617quan/NeonCarrot/CAD Files/PCB_Lid_a.stl

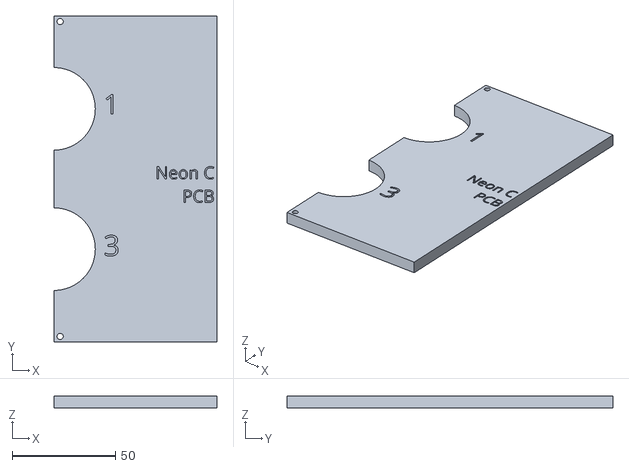
[picture p1: CAD file, 2026-05-02]
CAD Files/PCB_Lid_a.stl
79.0 x 158.0 x 6.00
