617quan/NeonCarrot/KiCad/12_Driver_Board/DRV8434PWPR/PWP0028M.stp

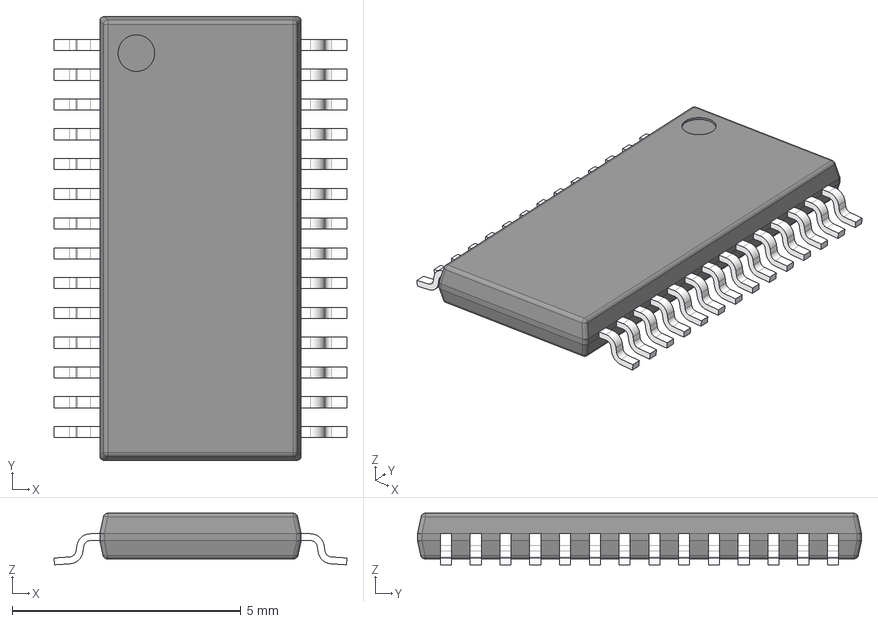
[picture p2: CAD file, 2026-02-03]
KiCad/12_Driver_Board/DRV8434PWPR/PWP0028M.stp
6.40 x 9.70 x 1.13 mm
BODY-TSSOP
LEAD-TSSOP x 28
PIN1
DAP
