617quan/NeonCarrot/KiCad/12_Driver_Board/ESP32-DEVKIT-V1/ESP32-DEVKIT-V1.step

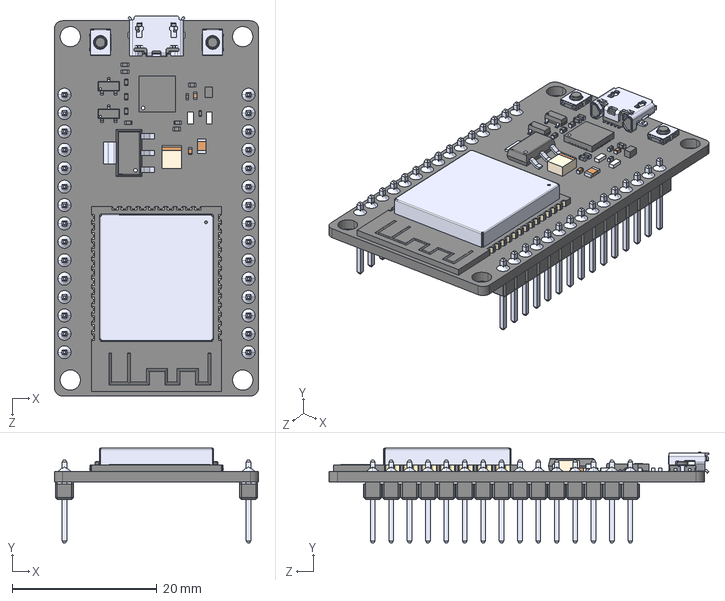
[picture p3: CAD file, 2026-02-25]
KiCad/12_Driver_Board/ESP32-DEVKIT-V1/ESP32-DEVKIT-V1.step
28.2 x 13.1 x 52.5 mm
