617quan/NeonCarrot/KiCad/12_Driver_Board/GRM188R71H224KAC4D/GRM188R71H224KAC4D.step

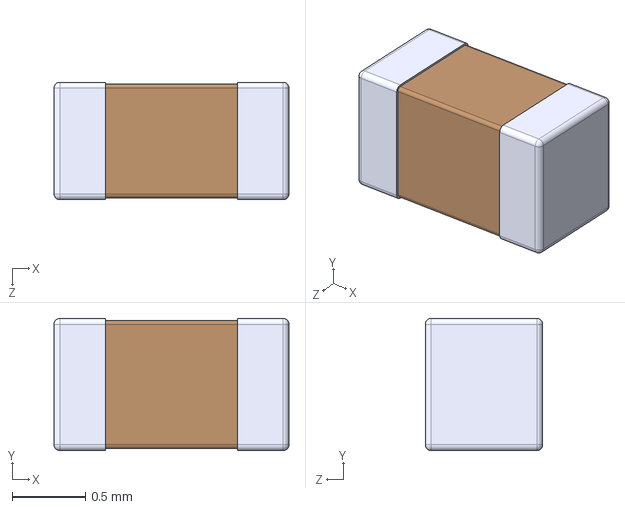
[picture p4: CAD file, 2026-02-05]
KiCad/12_Driver_Board/GRM188R71H224KAC4D/GRM188R71H224KAC4D.step
1.60 x 0.9 x 0.8 mm
