617quan/NeonCarrot/KiCad/12_Driver_Board/UMK107AB7105KA_T/UMK107AB7105KA-T.step

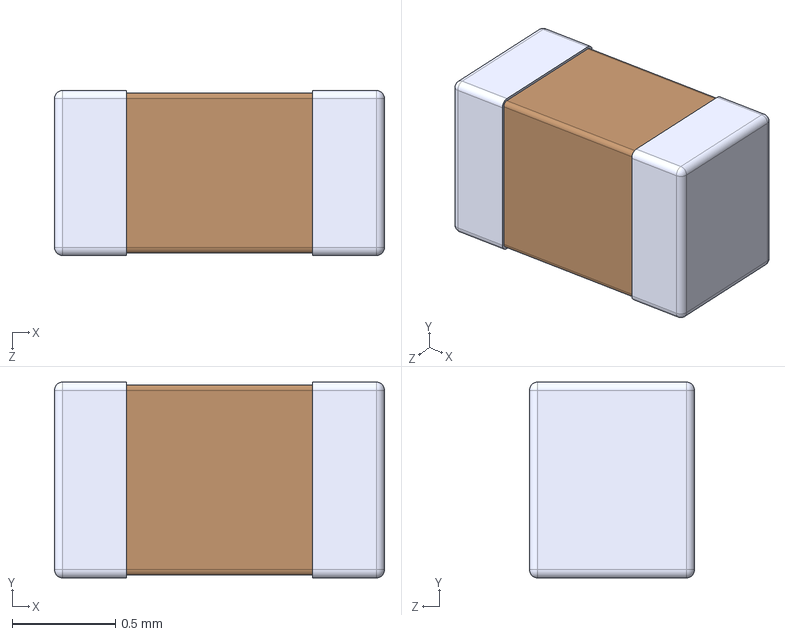
[picture p5: CAD file, 2026-02-05]
KiCad/12_Driver_Board/UMK107AB7105KA_T/UMK107AB7105KA-T.step
1.60 x 0.95 x 0.8 mm
