617quan/NeonCarrot/KiCad/2ESP_Breakout/JST-PH_Connectors/B6B-PH-K-S.step

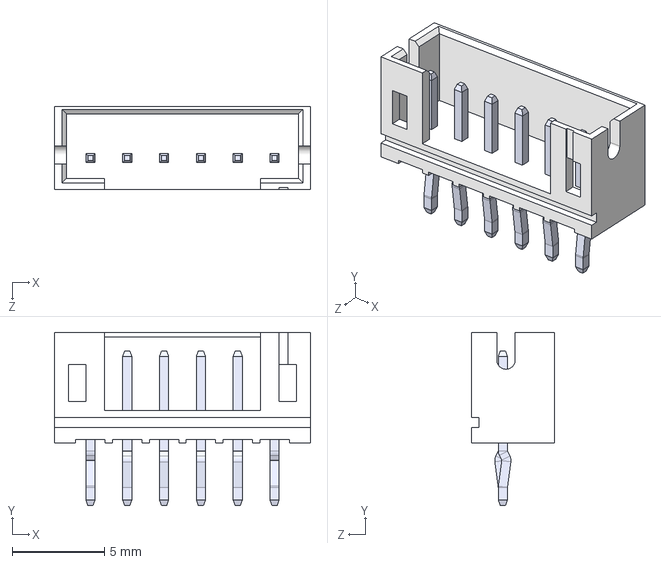
[picture p6: CAD file, 2026-01-23]
KiCad/2ESP_Breakout/JST-PH_Connectors/B6B-PH-K-S.step
13.9 x 9.40 x 4.50 mm
pin x 6
