617quan/NeonCarrot/CAD Files/PCB_Case_Bottom.stl

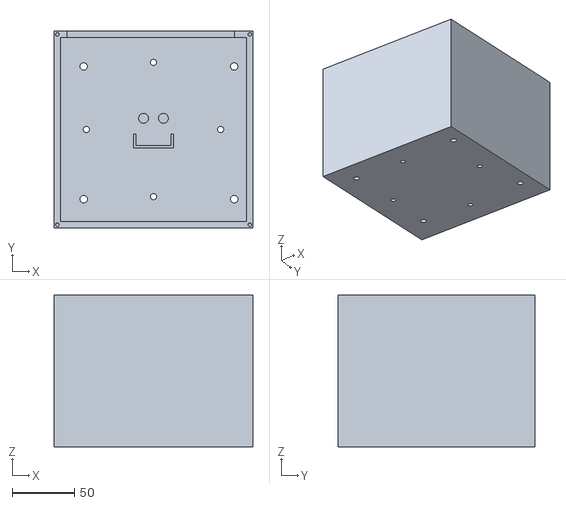
[picture p7: CAD file, 2026-05-02]
CAD Files/PCB_Case_Bottom.stl
160.0 x 158.0 x 122.0
