617quan/NeonCarrot/CAD Files/Stepper_3Chain(4-13).STL

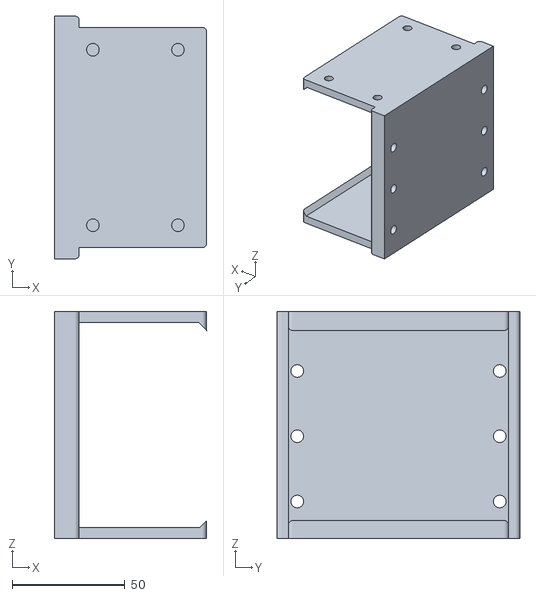
[picture p8: CAD file, 2026-05-02]
CAD Files/Stepper_3Chain(4-13).STL
67.6 x 108.0 x 101.0
