617quan/NeonCarrot/CAD Files/Stepper_3Chain_BothHoles.STL

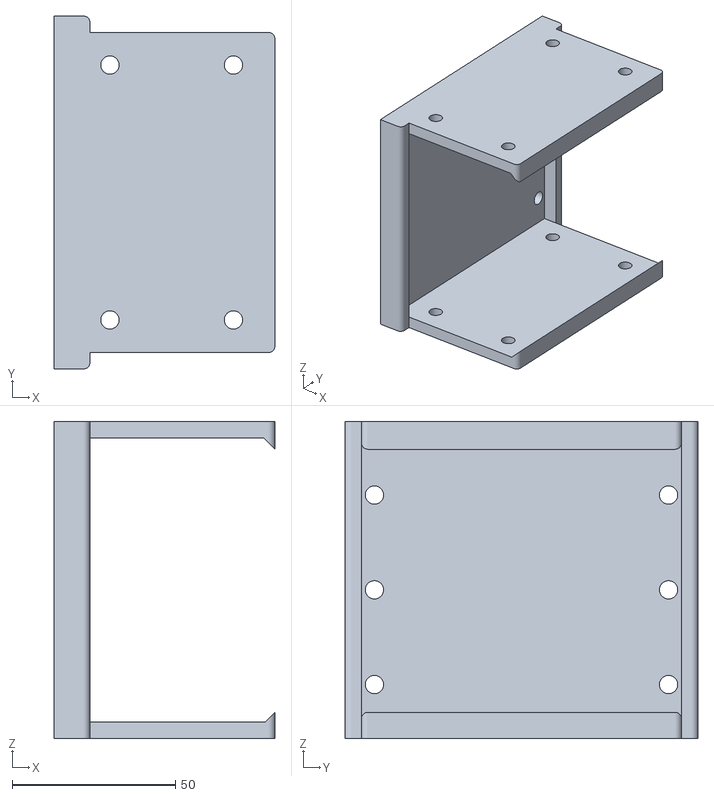
[picture p9: CAD file, 2026-05-02]
CAD Files/Stepper_3Chain_BothHoles.STL
67.6 x 108.0 x 97.0
