617quan/NeonCarrot/KiCad/12_Driver_Board/12_Driver_Board.kicad_pcb

## KiCad design KiCad/12_Driver_Board/12_Driver_Board.kicad_pcb (2026-05-02)

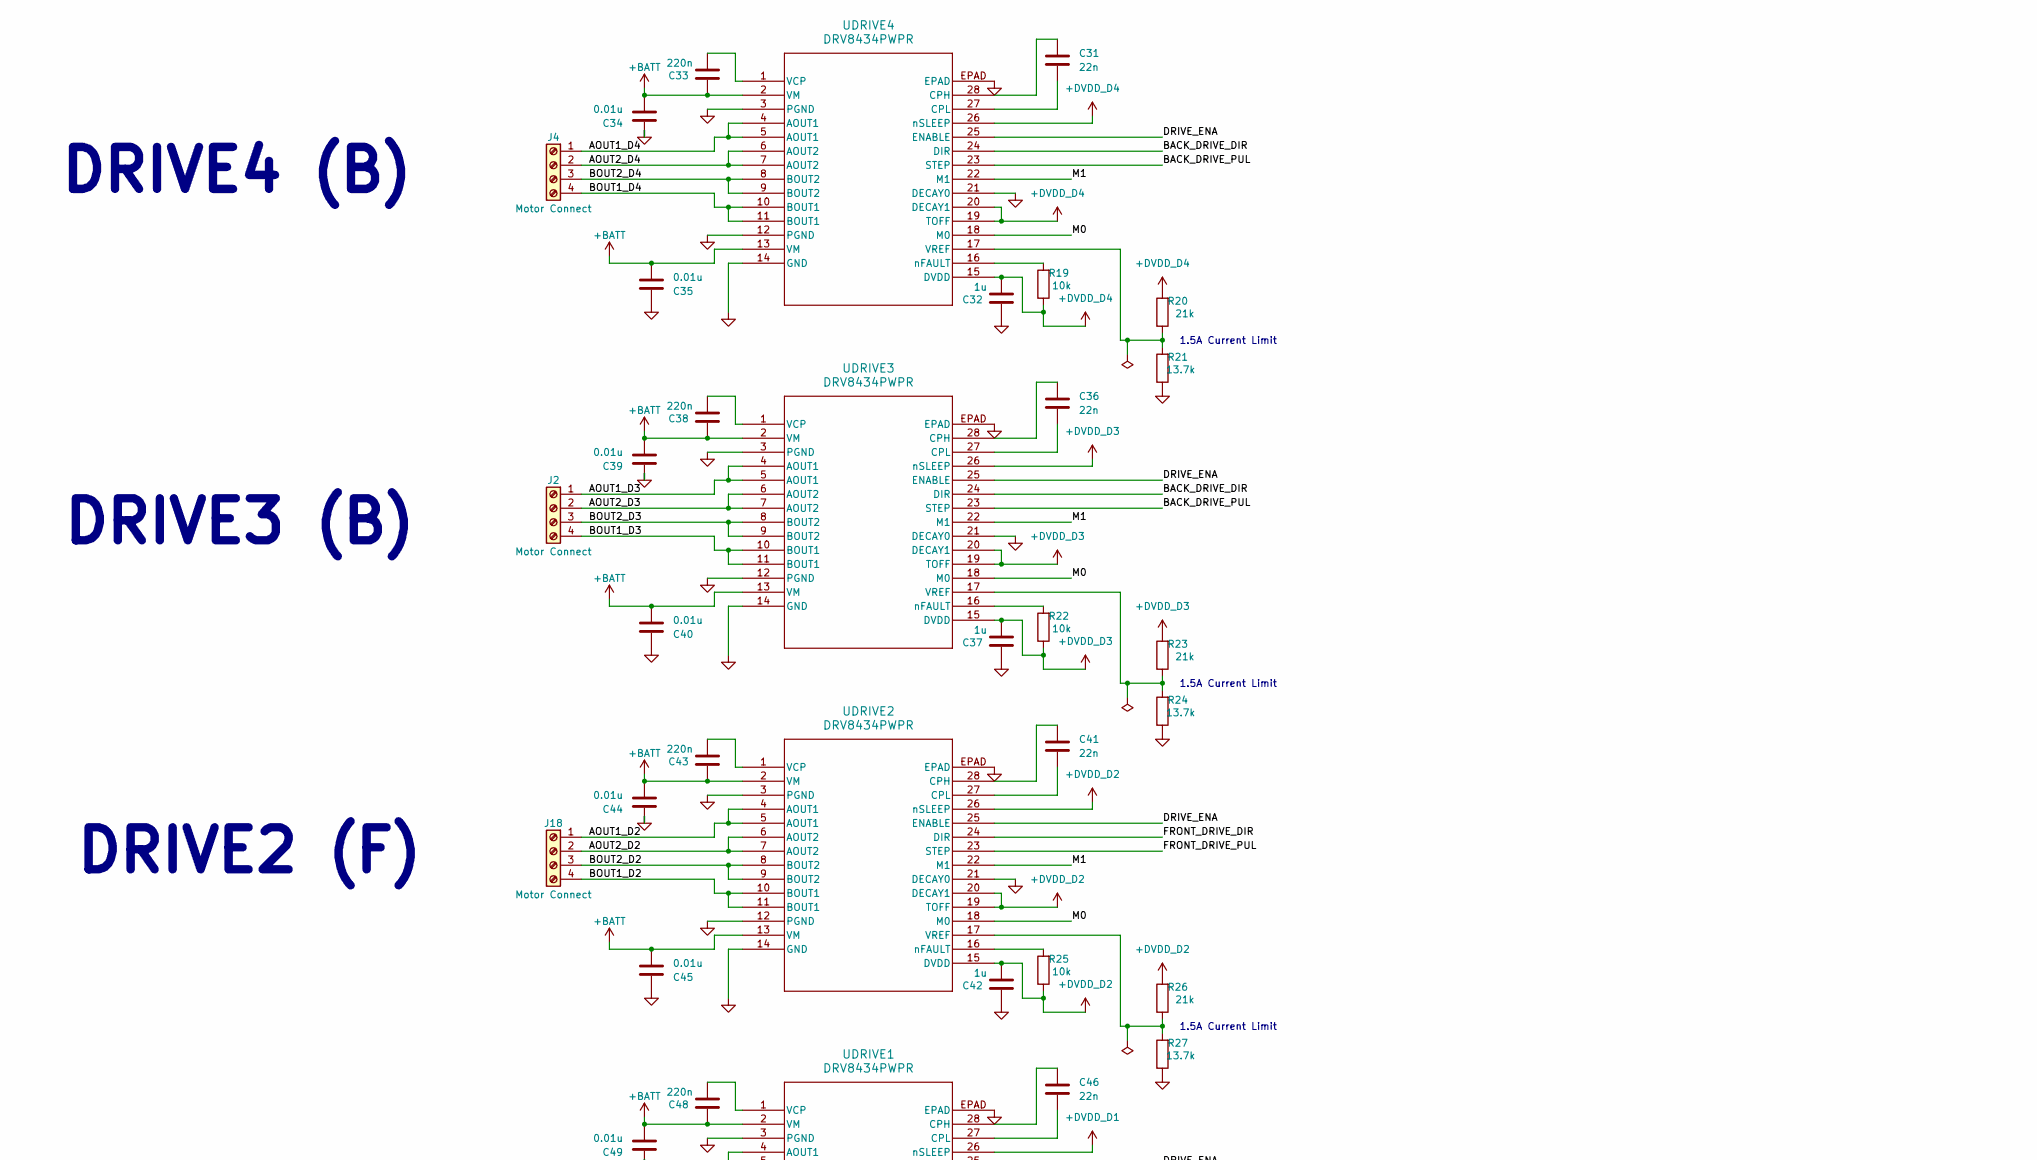
[picture p10: schematic 12_Driver_Board.kicad_sch, part in row 1, column 1]

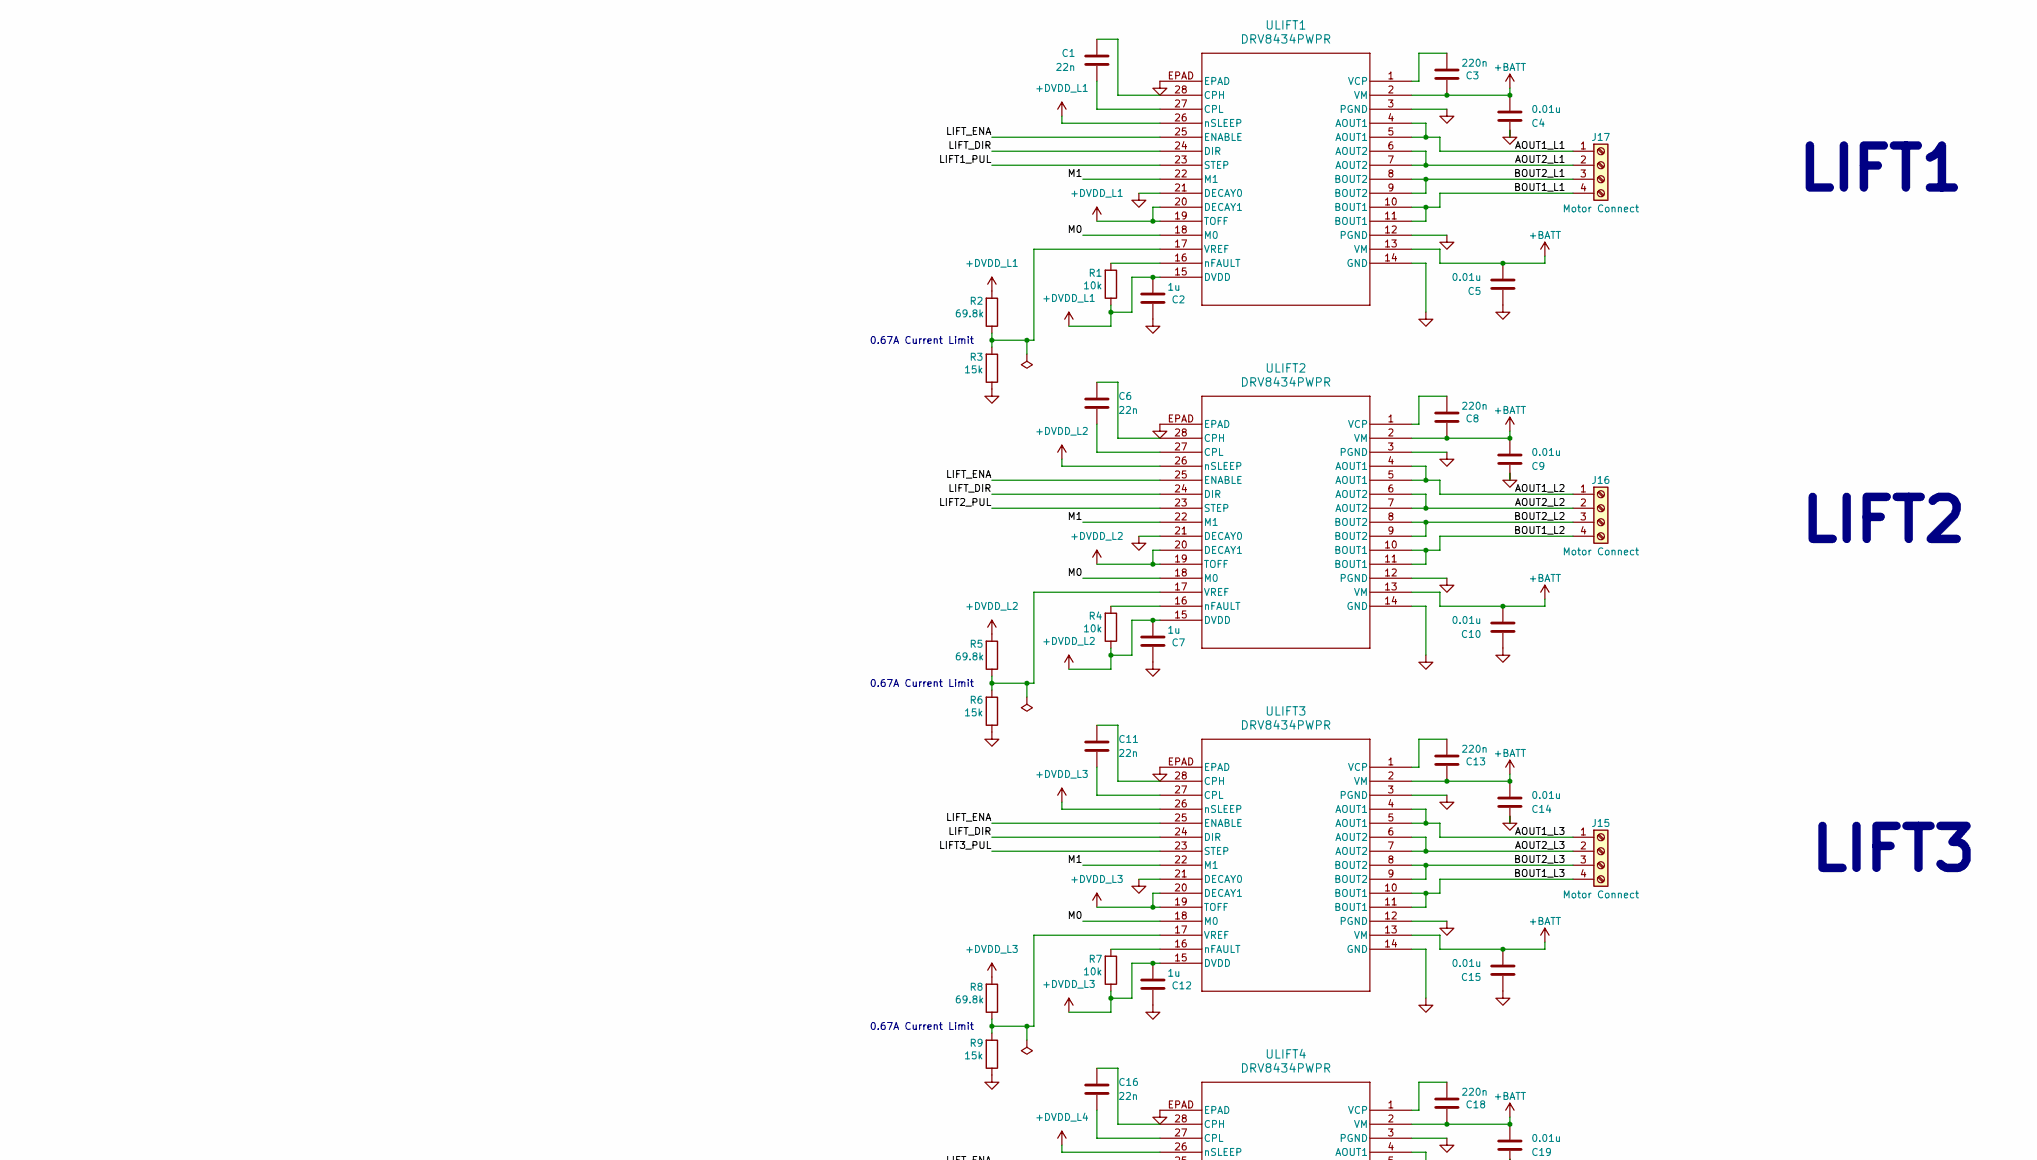
[picture p11: schematic 12_Driver_Board.kicad_sch, part in row 1, column 2]

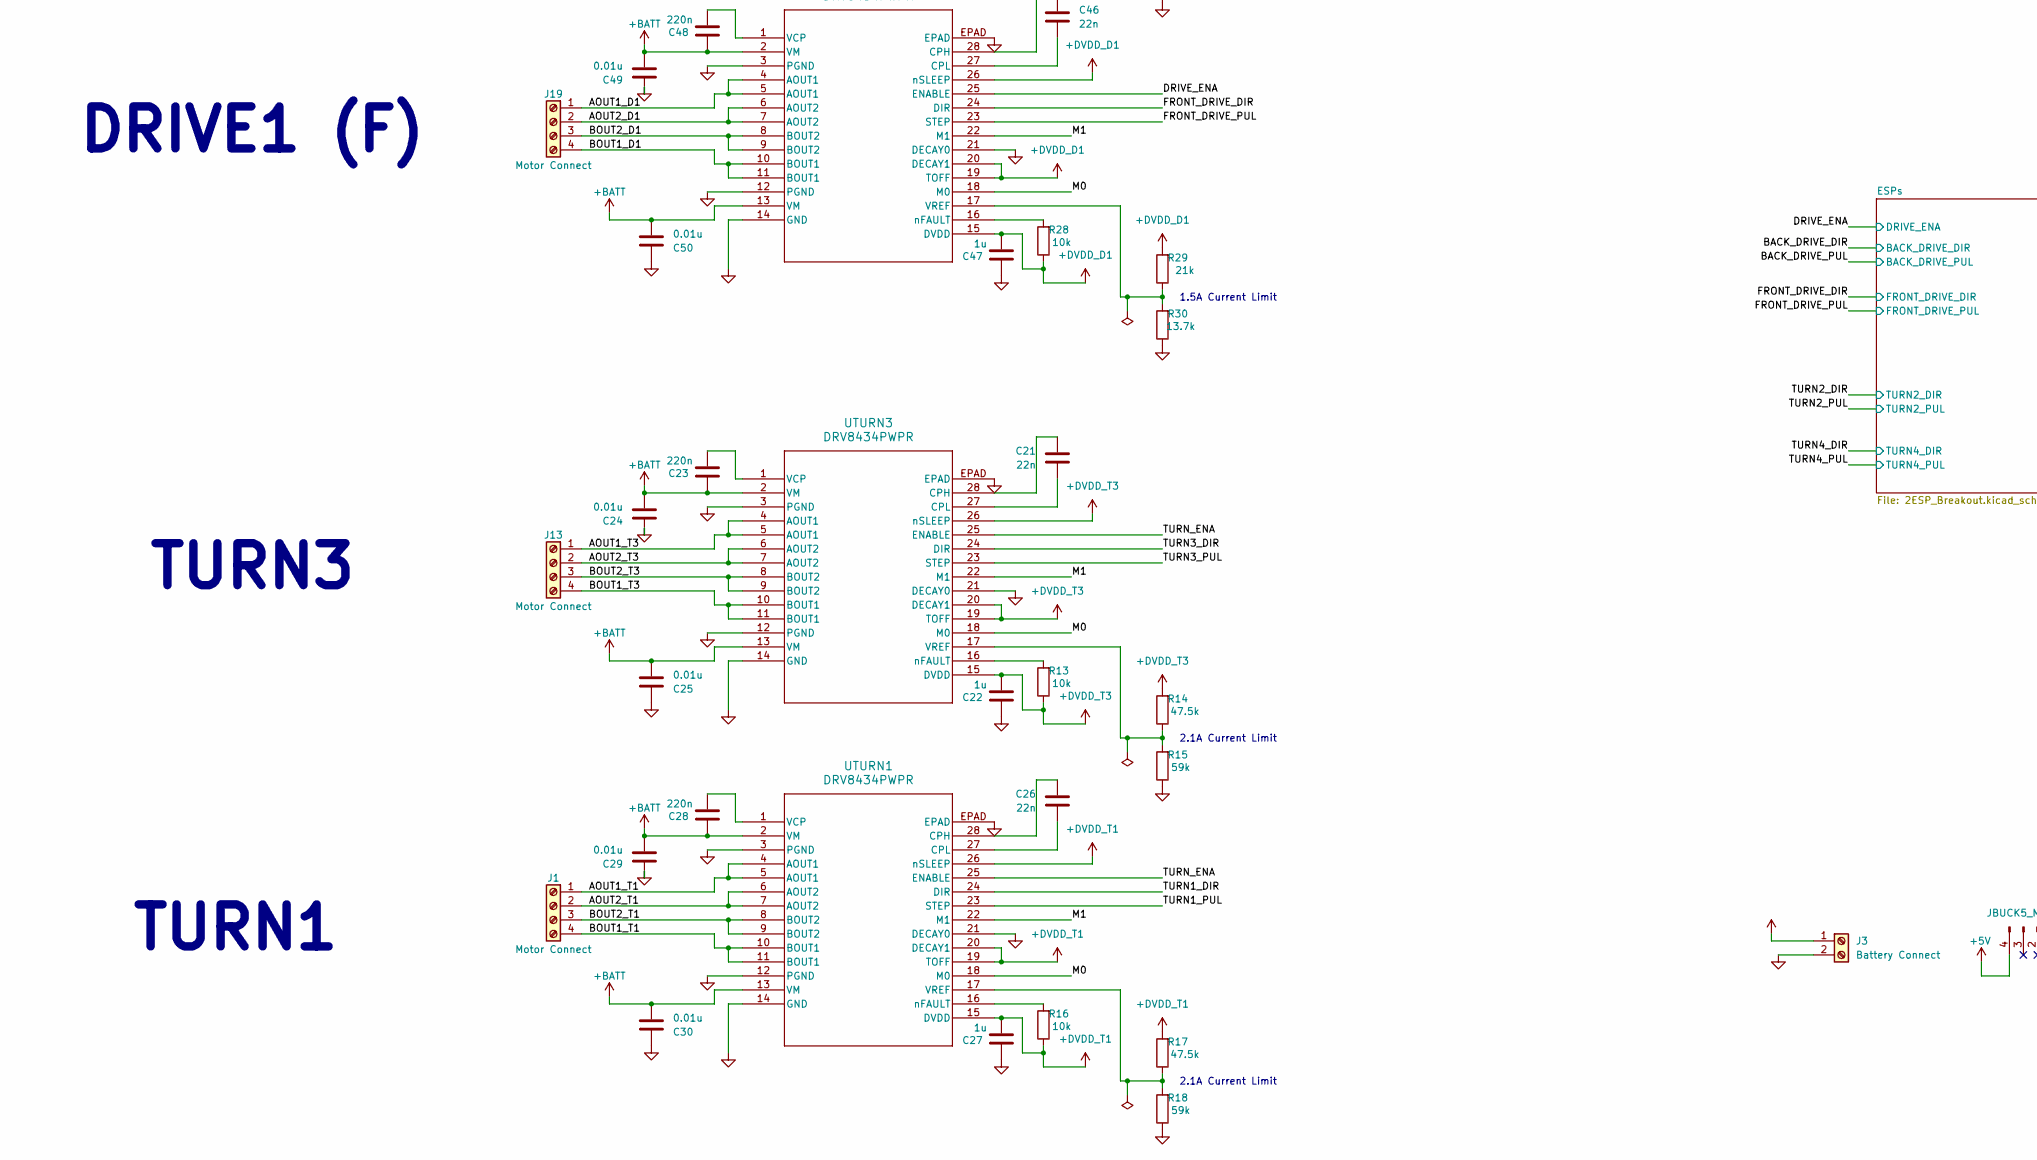
[picture p12: schematic 12_Driver_Board.kicad_sch, part in row 2, column 1]

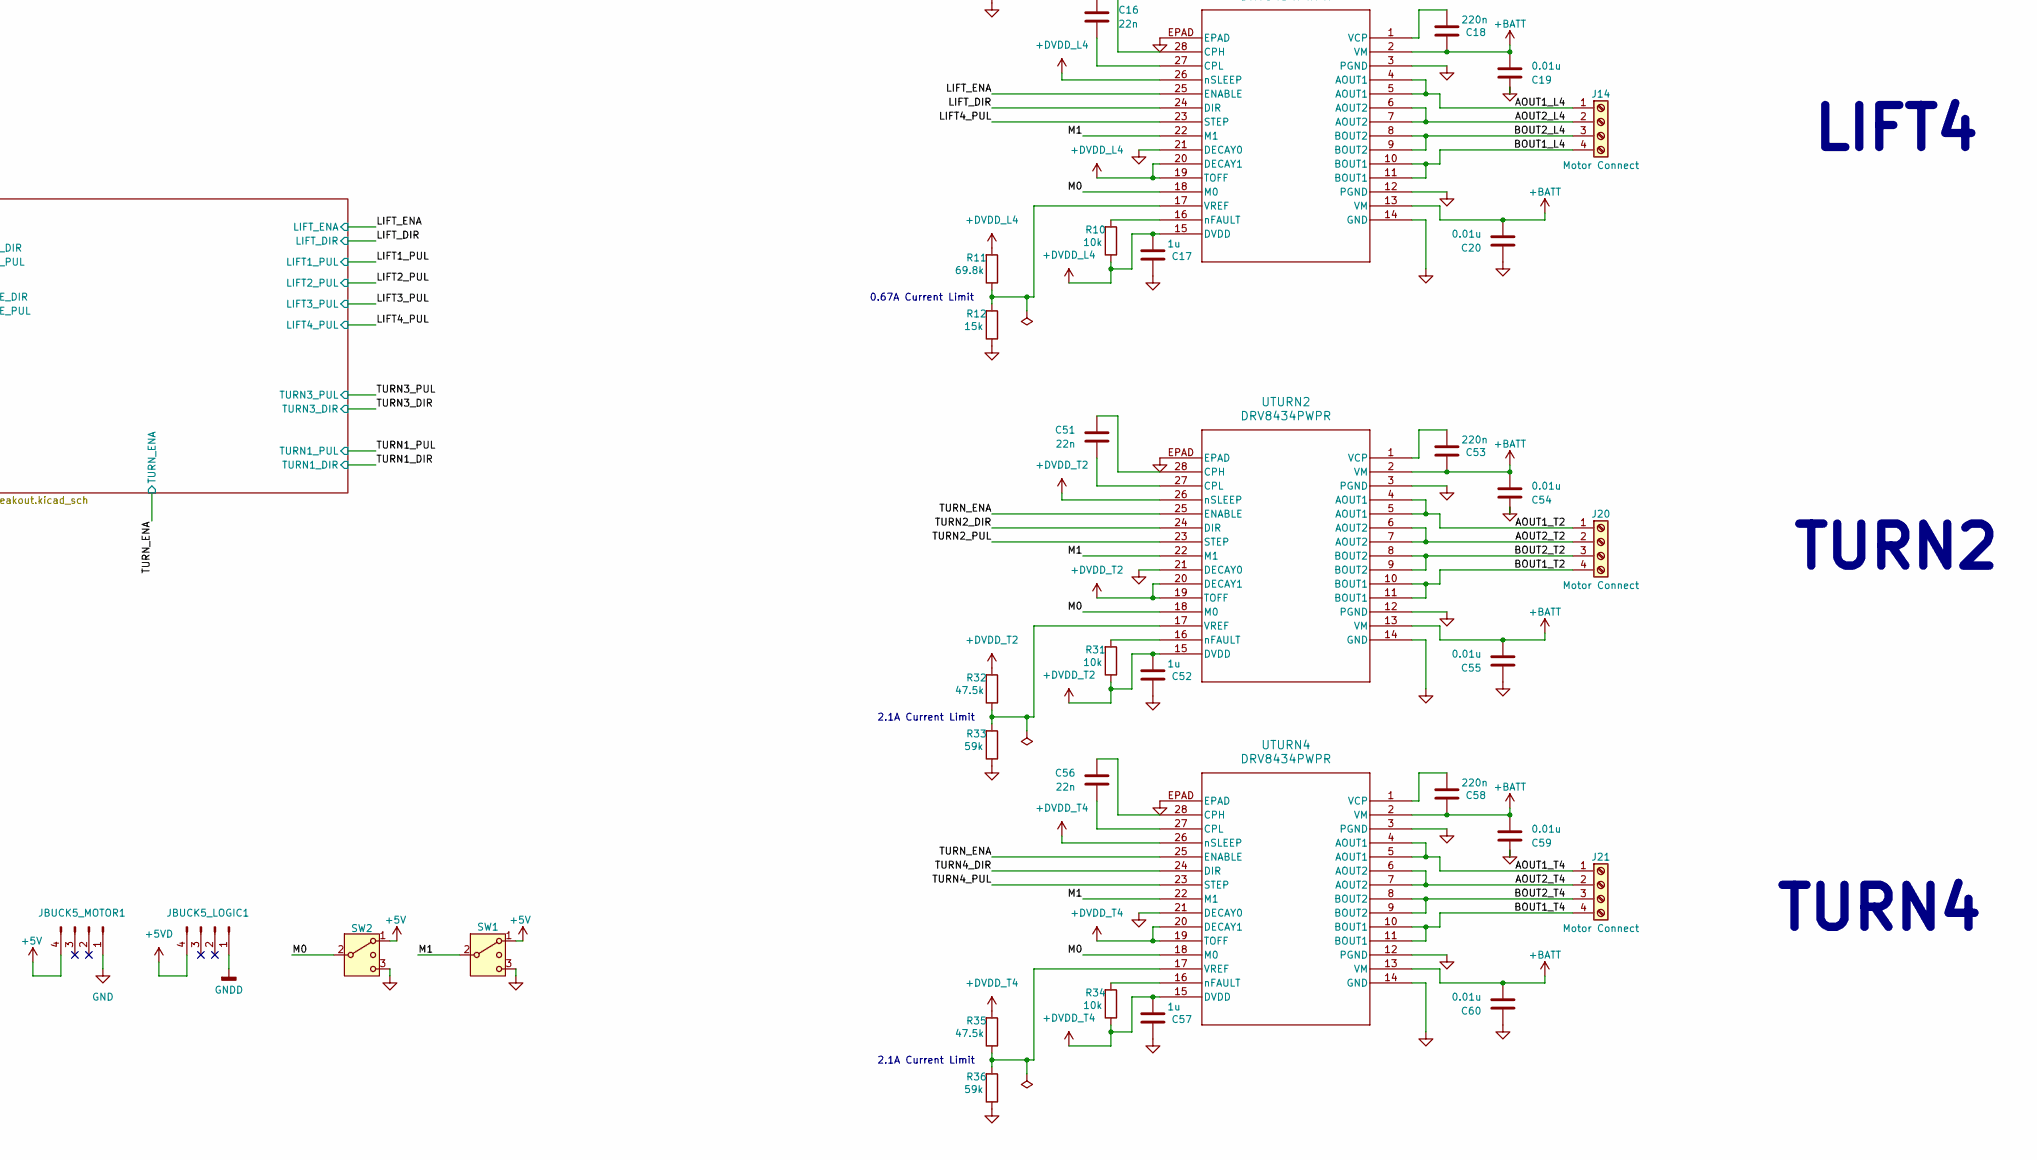
[picture p13: schematic 12_Driver_Board.kicad_sch, part in row 2, column 2]

Parts:
C1, C6, C11, C16, C21, C26, C31, C36, C41, C46, C51, C56: 22n; C_0603_1608Metric
C2, C7, C12, C17, C22, C27, C32, C37, C42, C47, C52, C57: 1u; C_0603_1608Metric
C3, C8, C13, C18, C23, C28, C33, C38, C43, C48, C53, C58: 220n; C_0603_1608Metric
C4, C5, C9, C10, C14, C15, C19, C20, C24, C25, C29, C30, C34, C35, C39, C40, C44, C45, C49, C50, C54, C55, C59, C60: 0.01u; C_0603_1608Metric
J1, J2, J4, J13, J14, J15, J16, J17, J18, J19, J20, J21: Motor Connect; PhoenixContact_MSTBA_2,5_4-G-5,08_1x04_P5.08mm_Horizontal
J3: Battery Connect; PhoenixContact_MSTBA_2,5_2-G-5,08_1x02_P5.08mm_Horizontal
JBUCK5_LOGIC1, JBUCK5_MOTOR1: Conn_01x04_Pin
R1, R4, R7, R10, R13, R16, R19, R22, R25, R28, R31, R34: 10k; R_0603_1608Metric
R2, R5, R8, R11: 69.8k; R_0603_1608Metric
R3, R6, R9, R12: 15k; R_0603_1608Metric
R14, R17, R32, R35: 47.5k; R_0603_1608Metric
R15, R18, R33, R36: 59k; R_0603_1608Metric
R20, R23, R26, R29: 21k; R_0603_1608Metric
R21, R24, R27, R30: 13.7k; R_0603_1608Metric
SW1, SW2: SW_SPDT_MSM; SW_Slide_SPDT_Straight_CK_OS102011MS2Q
UDRIVE1, UDRIVE2, UDRIVE3, UDRIVE4: DRV8434PWPR; TSSOP_34PWPR_TEX
ULIFT1, ULIFT2, ULIFT3, ULIFT4: DRV8434PWPR; TSSOP_34PWPR_TEX
UTURN1, UTURN2, UTURN3, UTURN4: DRV8434PWPR; TSSOP_34PWPR_TEX

Connections:
+5V: JBUCK5_MOTOR1.4, SW1.1, SW2.1; also elsewhere on the board
+BATT: C3.2, C4.1, C5.1, C8.2, C9.1, C10.1, C13.2, C14.1, C15.1, C18.2, C19.1, C20.1, C23.2, C24.1, C25.1, C28.2, C29.1, C30.1, C33.2, C34.1, C35.1, C38.2, C39.1, C40.1, C43.2, C44.1, C45.1, C48.2, C49.1, C50.1, C53.2, C54.1, C55.1, C58.2, C59.1, C60.1, J3.1, UDRIVE1.2 (VM), UDRIVE1.13 (VM), UDRIVE2.2 (VM), UDRIVE2.13 (VM), UDRIVE3.2 (VM), UDRIVE3.13 (VM), UDRIVE4.2 (VM), UDRIVE4.13 (VM), ULIFT1.2 (VM), ULIFT1.13 (VM), ULIFT2.2 (VM), ULIFT2.13 (VM), ULIFT3.2 (VM), ULIFT3.13 (VM), ULIFT4.2 (VM), ULIFT4.13 (VM), UTURN1.2 (VM), UTURN1.13 (VM), UTURN2.2 (VM), UTURN2.13 (VM), UTURN3.2 (VM), UTURN3.13 (VM), UTURN4.2 (VM), UTURN4.13 (VM)
+DVDD_D1: C47.1, R28.1, R29.2, UDRIVE1.15 (DVDD), UDRIVE1.19 (TOFF), UDRIVE1.20 (DECAY1), UDRIVE1.26 (nSLEEP)
+DVDD_D2: C42.1, R25.1, R26.2, UDRIVE2.15 (DVDD), UDRIVE2.19 (TOFF), UDRIVE2.20 (DECAY1), UDRIVE2.26 (nSLEEP)
+DVDD_D3: C37.1, R22.1, R23.2, UDRIVE3.15 (DVDD), UDRIVE3.19 (TOFF), UDRIVE3.20 (DECAY1), UDRIVE3.26 (nSLEEP)
+DVDD_D4: C32.1, R19.1, R20.2, UDRIVE4.15 (DVDD), UDRIVE4.19 (TOFF), UDRIVE4.20 (DECAY1), UDRIVE4.26 (nSLEEP)
+DVDD_L1: C2.1, R1.1, R2.2, ULIFT1.15 (DVDD), ULIFT1.19 (TOFF), ULIFT1.20 (DECAY1), ULIFT1.26 (nSLEEP)
+DVDD_L2: C7.1, R4.1, R5.2, ULIFT2.15 (DVDD), ULIFT2.19 (TOFF), ULIFT2.20 (DECAY1), ULIFT2.26 (nSLEEP)
+DVDD_L3: C12.1, R7.1, R8.2, ULIFT3.15 (DVDD), ULIFT3.19 (TOFF), ULIFT3.20 (DECAY1), ULIFT3.26 (nSLEEP)
+DVDD_L4: C17.1, R10.1, R11.2, ULIFT4.15 (DVDD), ULIFT4.19 (TOFF), ULIFT4.20 (DECAY1), ULIFT4.26 (nSLEEP)
+DVDD_T1: C27.1, R16.1, R17.2, UTURN1.15 (DVDD), UTURN1.19 (TOFF), UTURN1.20 (DECAY1), UTURN1.26 (nSLEEP)
+DVDD_T2: C52.1, R31.1, R32.2, UTURN2.15 (DVDD), UTURN2.19 (TOFF), UTURN2.20 (DECAY1), UTURN2.26 (nSLEEP)
+DVDD_T3: C22.1, R13.1, R14.2, UTURN3.15 (DVDD), UTURN3.19 (TOFF), UTURN3.20 (DECAY1), UTURN3.26 (nSLEEP)
+DVDD_T4: C57.1, R34.1, R35.2, UTURN4.15 (DVDD), UTURN4.19 (TOFF), UTURN4.20 (DECAY1), UTURN4.26 (nSLEEP)
/AOUT1_D1: J19.1, UDRIVE1.4 (AOUT1), UDRIVE1.5 (AOUT1)
/AOUT1_D2: J18.1, UDRIVE2.4 (AOUT1), UDRIVE2.5 (AOUT1)
/AOUT1_D3: J2.1, UDRIVE3.4 (AOUT1), UDRIVE3.5 (AOUT1)
/AOUT1_D4: J4.1, UDRIVE4.4 (AOUT1), UDRIVE4.5 (AOUT1)
/AOUT1_L1: J17.1, ULIFT1.4 (AOUT1), ULIFT1.5 (AOUT1)
/AOUT1_L2: J16.1, ULIFT2.4 (AOUT1), ULIFT2.5 (AOUT1)
/AOUT1_L3: J15.1, ULIFT3.4 (AOUT1), ULIFT3.5 (AOUT1)
/AOUT1_L4: J14.1, ULIFT4.4 (AOUT1), ULIFT4.5 (AOUT1)
/AOUT1_T1: J1.1, UTURN1.4 (AOUT1), UTURN1.5 (AOUT1)
/AOUT1_T2: J20.1, UTURN2.4 (AOUT1), UTURN2.5 (AOUT1)
/AOUT1_T3: J13.1, UTURN3.4 (AOUT1), UTURN3.5 (AOUT1)
/AOUT1_T4: J21.1, UTURN4.4 (AOUT1), UTURN4.5 (AOUT1)
/AOUT2_D1: J19.2, UDRIVE1.6 (AOUT2), UDRIVE1.7 (AOUT2)
/AOUT2_D2: J18.2, UDRIVE2.6 (AOUT2), UDRIVE2.7 (AOUT2)
/AOUT2_D3: J2.2, UDRIVE3.6 (AOUT2), UDRIVE3.7 (AOUT2)
/AOUT2_D4: J4.2, UDRIVE4.6 (AOUT2), UDRIVE4.7 (AOUT2)
/AOUT2_L1: J17.2, ULIFT1.6 (AOUT2), ULIFT1.7 (AOUT2)
/AOUT2_L2: J16.2, ULIFT2.6 (AOUT2), ULIFT2.7 (AOUT2)
/AOUT2_L3: J15.2, ULIFT3.6 (AOUT2), ULIFT3.7 (AOUT2)
/AOUT2_L4: J14.2, ULIFT4.6 (AOUT2), ULIFT4.7 (AOUT2)
/AOUT2_T1: J1.2, UTURN1.6 (AOUT2), UTURN1.7 (AOUT2)
/AOUT2_T2: J20.2, UTURN2.6 (AOUT2), UTURN2.7 (AOUT2)
/AOUT2_T3: J13.2, UTURN3.6 (AOUT2), UTURN3.7 (AOUT2)
/AOUT2_T4: J21.2, UTURN4.6 (AOUT2), UTURN4.7 (AOUT2)
/BACK_DRIVE_DIR: UDRIVE3.24 (DIR), UDRIVE4.24 (DIR); also elsewhere on the board
/BACK_DRIVE_PUL: UDRIVE3.23 (STEP), UDRIVE4.23 (STEP); also elsewhere on the board
/BOUT1_D1: J19.4, UDRIVE1.10 (BOUT1), UDRIVE1.11 (BOUT1)
/BOUT1_D2: J18.4, UDRIVE2.10 (BOUT1), UDRIVE2.11 (BOUT1)
/BOUT1_D3: J2.4, UDRIVE3.10 (BOUT1), UDRIVE3.11 (BOUT1)
/BOUT1_D4: J4.4, UDRIVE4.10 (BOUT1), UDRIVE4.11 (BOUT1)
/BOUT1_L1: J17.4, ULIFT1.10 (BOUT1), ULIFT1.11 (BOUT1)
/BOUT1_L2: J16.4, ULIFT2.10 (BOUT1), ULIFT2.11 (BOUT1)
/BOUT1_L3: J15.4, ULIFT3.10 (BOUT1), ULIFT3.11 (BOUT1)
/BOUT1_L4: J14.4, ULIFT4.10 (BOUT1), ULIFT4.11 (BOUT1)
/BOUT1_T1: J1.4, UTURN1.10 (BOUT1), UTURN1.11 (BOUT1)
/BOUT1_T2: J20.4, UTURN2.10 (BOUT1), UTURN2.11 (BOUT1)
/BOUT1_T3: J13.4, UTURN3.10 (BOUT1), UTURN3.11 (BOUT1)
/BOUT1_T4: J21.4, UTURN4.10 (BOUT1), UTURN4.11 (BOUT1)
/BOUT2_D1: J19.3, UDRIVE1.8 (BOUT2), UDRIVE1.9 (BOUT2)
/BOUT2_D2: J18.3, UDRIVE2.8 (BOUT2), UDRIVE2.9 (BOUT2)
/BOUT2_D3: J2.3, UDRIVE3.8 (BOUT2), UDRIVE3.9 (BOUT2)
/BOUT2_D4: J4.3, UDRIVE4.8 (BOUT2), UDRIVE4.9 (BOUT2)
/BOUT2_L1: J17.3, ULIFT1.8 (BOUT2), ULIFT1.9 (BOUT2)
/BOUT2_L2: J16.3, ULIFT2.8 (BOUT2), ULIFT2.9 (BOUT2)
/BOUT2_L3: J15.3, ULIFT3.8 (BOUT2), ULIFT3.9 (BOUT2)
/BOUT2_L4: J14.3, ULIFT4.8 (BOUT2), ULIFT4.9 (BOUT2)
/BOUT2_T1: J1.3, UTURN1.8 (BOUT2), UTURN1.9 (BOUT2)
/BOUT2_T2: J20.3, UTURN2.8 (BOUT2), UTURN2.9 (BOUT2)
/BOUT2_T3: J13.3, UTURN3.8 (BOUT2), UTURN3.9 (BOUT2)
/BOUT2_T4: J21.3, UTURN4.8 (BOUT2), UTURN4.9 (BOUT2)
/DRIVE_ENA: UDRIVE1.25 (ENABLE), UDRIVE2.25 (ENABLE), UDRIVE3.25 (ENABLE), UDRIVE4.25 (ENABLE); also elsewhere on the board
/FRONT_DRIVE_DIR: UDRIVE1.24 (DIR), UDRIVE2.24 (DIR); also elsewhere on the board
/FRONT_DRIVE_PUL: UDRIVE1.23 (STEP), UDRIVE2.23 (STEP); also elsewhere on the board
/LIFT1_PUL: ULIFT1.23 (STEP); also elsewhere on the board
/LIFT2_PUL: ULIFT2.23 (STEP); also elsewhere on the board
/LIFT3_PUL: ULIFT3.23 (STEP); also elsewhere on the board
/LIFT4_PUL: ULIFT4.23 (STEP); also elsewhere on the board
/LIFT_DIR: ULIFT1.24 (DIR), ULIFT2.24 (DIR), ULIFT3.24 (DIR), ULIFT4.24 (DIR); also elsewhere on the board
/LIFT_ENA: ULIFT1.25 (ENABLE), ULIFT2.25 (ENABLE), ULIFT3.25 (ENABLE), ULIFT4.25 (ENABLE); also elsewhere on the board
/M0: SW2.2 (3), UDRIVE1.18 (M0), UDRIVE2.18 (M0), UDRIVE3.18 (M0), UDRIVE4.18 (M0), ULIFT1.18 (M0), ULIFT2.18 (M0), ULIFT3.18 (M0), ULIFT4.18 (M0), UTURN1.18 (M0), UTURN2.18 (M0), UTURN3.18 (M0), UTURN4.18 (M0)
/M1: SW1.2 (3), UDRIVE1.22 (M1), UDRIVE2.22 (M1), UDRIVE3.22 (M1), UDRIVE4.22 (M1), ULIFT1.22 (M1), ULIFT2.22 (M1), ULIFT3.22 (M1), ULIFT4.22 (M1), UTURN1.22 (M1), UTURN2.22 (M1), UTURN3.22 (M1), UTURN4.22 (M1)
/TURN1_DIR: UTURN1.24 (DIR); also elsewhere on the board
/TURN1_PUL: UTURN1.23 (STEP); also elsewhere on the board
/TURN2_DIR: UTURN2.24 (DIR); also elsewhere on the board
/TURN2_PUL: UTURN2.23 (STEP); also elsewhere on the board
/TURN3_DIR: UTURN3.24 (DIR); also elsewhere on the board
/TURN3_PUL: UTURN3.23 (STEP); also elsewhere on the board
/TURN4_DIR: UTURN4.24 (DIR); also elsewhere on the board
/TURN4_PUL: UTURN4.23 (STEP); also elsewhere on the board
/TURN_ENA: UTURN1.25 (ENABLE), UTURN2.25 (ENABLE), UTURN3.25 (ENABLE), UTURN4.25 (ENABLE); also elsewhere on the board
GND: C2.2, C4.2, C5.2, C7.2, C9.2, C10.2, C12.2, C14.2, C15.2, C17.2, C19.2, C20.2, C22.2, C24.2, C25.2, C27.2, C29.2, C30.2, C32.2, C34.2, C35.2, C37.2, C39.2, C40.2, C42.2, C44.2, C45.2, C47.2, C49.2, C50.2, C52.2, C54.2, C55.2, C57.2, C59.2, C60.2, J3.2, JBUCK5_MOTOR1.1, R3.1, R6.1, R9.1, R12.1, R15.1, R18.1, R21.1, R24.1, R27.1, R30.1, R33.1, R36.1, SW1.3 (4), SW2.3 (4), UDRIVE1.3 (PGND), UDRIVE1.12 (PGND), UDRIVE1.14 (GND), UDRIVE1.21 (DECAY0), UDRIVE1.EPAD, UDRIVE2.3 (PGND), UDRIVE2.12 (PGND), UDRIVE2.14 (GND), UDRIVE2.21 (DECAY0), UDRIVE2.EPAD, UDRIVE3.3 (PGND), UDRIVE3.12 (PGND), UDRIVE3.14 (GND), UDRIVE3.21 (DECAY0), UDRIVE3.EPAD, UDRIVE4.3 (PGND), UDRIVE4.12 (PGND), UDRIVE4.14 (GND), UDRIVE4.21 (DECAY0), UDRIVE4.EPAD, ULIFT1.3 (PGND), ULIFT1.12 (PGND), ULIFT1.14 (GND), ULIFT1.21 (DECAY0), ULIFT1.EPAD, ULIFT2.3 (PGND), ULIFT2.12 (PGND), ULIFT2.14 (GND), ULIFT2.21 (DECAY0), ULIFT2.EPAD, ULIFT3.3 (PGND), ULIFT3.12 (PGND), ULIFT3.14 (GND), ULIFT3.21 (DECAY0), ULIFT3.EPAD, ULIFT4.3 (PGND), ULIFT4.12 (PGND), ULIFT4.14 (GND), ULIFT4.21 (DECAY0), ULIFT4.EPAD, UTURN1.3 (PGND), UTURN1.12 (PGND), UTURN1.14 (GND), UTURN1.21 (DECAY0), UTURN1.EPAD, UTURN2.3 (PGND), UTURN2.12 (PGND), UTURN2.14 (GND), UTURN2.21 (DECAY0), UTURN2.EPAD, UTURN3.3 (PGND), UTURN3.12 (PGND), UTURN3.14 (GND), UTURN3.21 (DECAY0), UTURN3.EPAD, UTURN4.3 (PGND), UTURN4.12 (PGND), UTURN4.14 (GND), UTURN4.21 (DECAY0), UTURN4.EPAD; also elsewhere on the board
unnamed: C46.1, UDRIVE1.28 (CPH)
unnamed: C46.2, UDRIVE1.27 (CPL)
unnamed: C48.1, UDRIVE1.1 (VCP)
unnamed: R29.1, R30.2, UDRIVE1.17 (VREF)
unnamed: R28.2, UDRIVE1.16 (nFAULT)
unnamed: C41.1, UDRIVE2.28 (CPH)
unnamed: C41.2, UDRIVE2.27 (CPL)
unnamed: C43.1, UDRIVE2.1 (VCP)
unnamed: R26.1, R27.2, UDRIVE2.17 (VREF)
unnamed: R25.2, UDRIVE2.16 (nFAULT)
unnamed: C36.1, UDRIVE3.28 (CPH)
unnamed: C36.2, UDRIVE3.27 (CPL)
unnamed: C38.1, UDRIVE3.1 (VCP)
unnamed: R23.1, R24.2, UDRIVE3.17 (VREF)
unnamed: R22.2, UDRIVE3.16 (nFAULT)
unnamed: C31.1, UDRIVE4.28 (CPH)
unnamed: C31.2, UDRIVE4.27 (CPL)
unnamed: C33.1, UDRIVE4.1 (VCP)
unnamed: R20.1, R21.2, UDRIVE4.17 (VREF)
unnamed: R19.2, UDRIVE4.16 (nFAULT)
unnamed: C1.1, ULIFT1.28 (CPH)
unnamed: C1.2, ULIFT1.27 (CPL)
unnamed: C3.1, ULIFT1.1 (VCP)
unnamed: R2.1, R3.2, ULIFT1.17 (VREF)
unnamed: R1.2, ULIFT1.16 (nFAULT)
unnamed: C6.1, ULIFT2.28 (CPH)
unnamed: C6.2, ULIFT2.27 (CPL)
unnamed: C8.1, ULIFT2.1 (VCP)
unnamed: R5.1, R6.2, ULIFT2.17 (VREF)
unnamed: R4.2, ULIFT2.16 (nFAULT)
unnamed: C11.1, ULIFT3.28 (CPH)
unnamed: C11.2, ULIFT3.27 (CPL)
unnamed: C13.1, ULIFT3.1 (VCP)
unnamed: R8.1, R9.2, ULIFT3.17 (VREF)
unnamed: R7.2, ULIFT3.16 (nFAULT)
unnamed: C16.1, ULIFT4.28 (CPH)
unnamed: C16.2, ULIFT4.27 (CPL)
unnamed: C18.1, ULIFT4.1 (VCP)
unnamed: R11.1, R12.2, ULIFT4.17 (VREF)
unnamed: R10.2, ULIFT4.16 (nFAULT)
unnamed: C26.1, UTURN1.28 (CPH)
unnamed: C26.2, UTURN1.27 (CPL)
unnamed: C28.1, UTURN1.1 (VCP)
unnamed: R17.1, R18.2, UTURN1.17 (VREF)
unnamed: R16.2, UTURN1.16 (nFAULT)
unnamed: C51.1, UTURN2.28 (CPH)
unnamed: C51.2, UTURN2.27 (CPL)
unnamed: C53.1, UTURN2.1 (VCP)
unnamed: R32.1, R33.2, UTURN2.17 (VREF)
unnamed: R31.2, UTURN2.16 (nFAULT)
unnamed: C21.1, UTURN3.28 (CPH)
unnamed: C21.2, UTURN3.27 (CPL)
unnamed: C23.1, UTURN3.1 (VCP)
unnamed: R14.1, R15.2, UTURN3.17 (VREF)
unnamed: R13.2, UTURN3.16 (nFAULT)
unnamed: C56.1, UTURN4.28 (CPH)
unnamed: C56.2, UTURN4.27 (CPL)
unnamed: C58.1, UTURN4.1 (VCP)
unnamed: R35.1, R36.2, UTURN4.17 (VREF)
unnamed: R34.2, UTURN4.16 (nFAULT)

Notes on the sheet:
DRIVE3 (B)
0.67A Current Limit
TURN2
2.1A Current Limit
TURN4
LIFT4
DRIVE2 (F)
1.5A Current Limit
LIFT1
LIFT2
DRIVE4 (B)
TURN3
DRIVE1 (F)
TURN1
LIFT3
