617quan/NeonCarrot/KiCad/12_Driver_Board/12_Driver_Board.kicad_pcb

## KiCad design KiCad/12_Driver_Board/12_Driver_Board.kicad_pcb (continued)

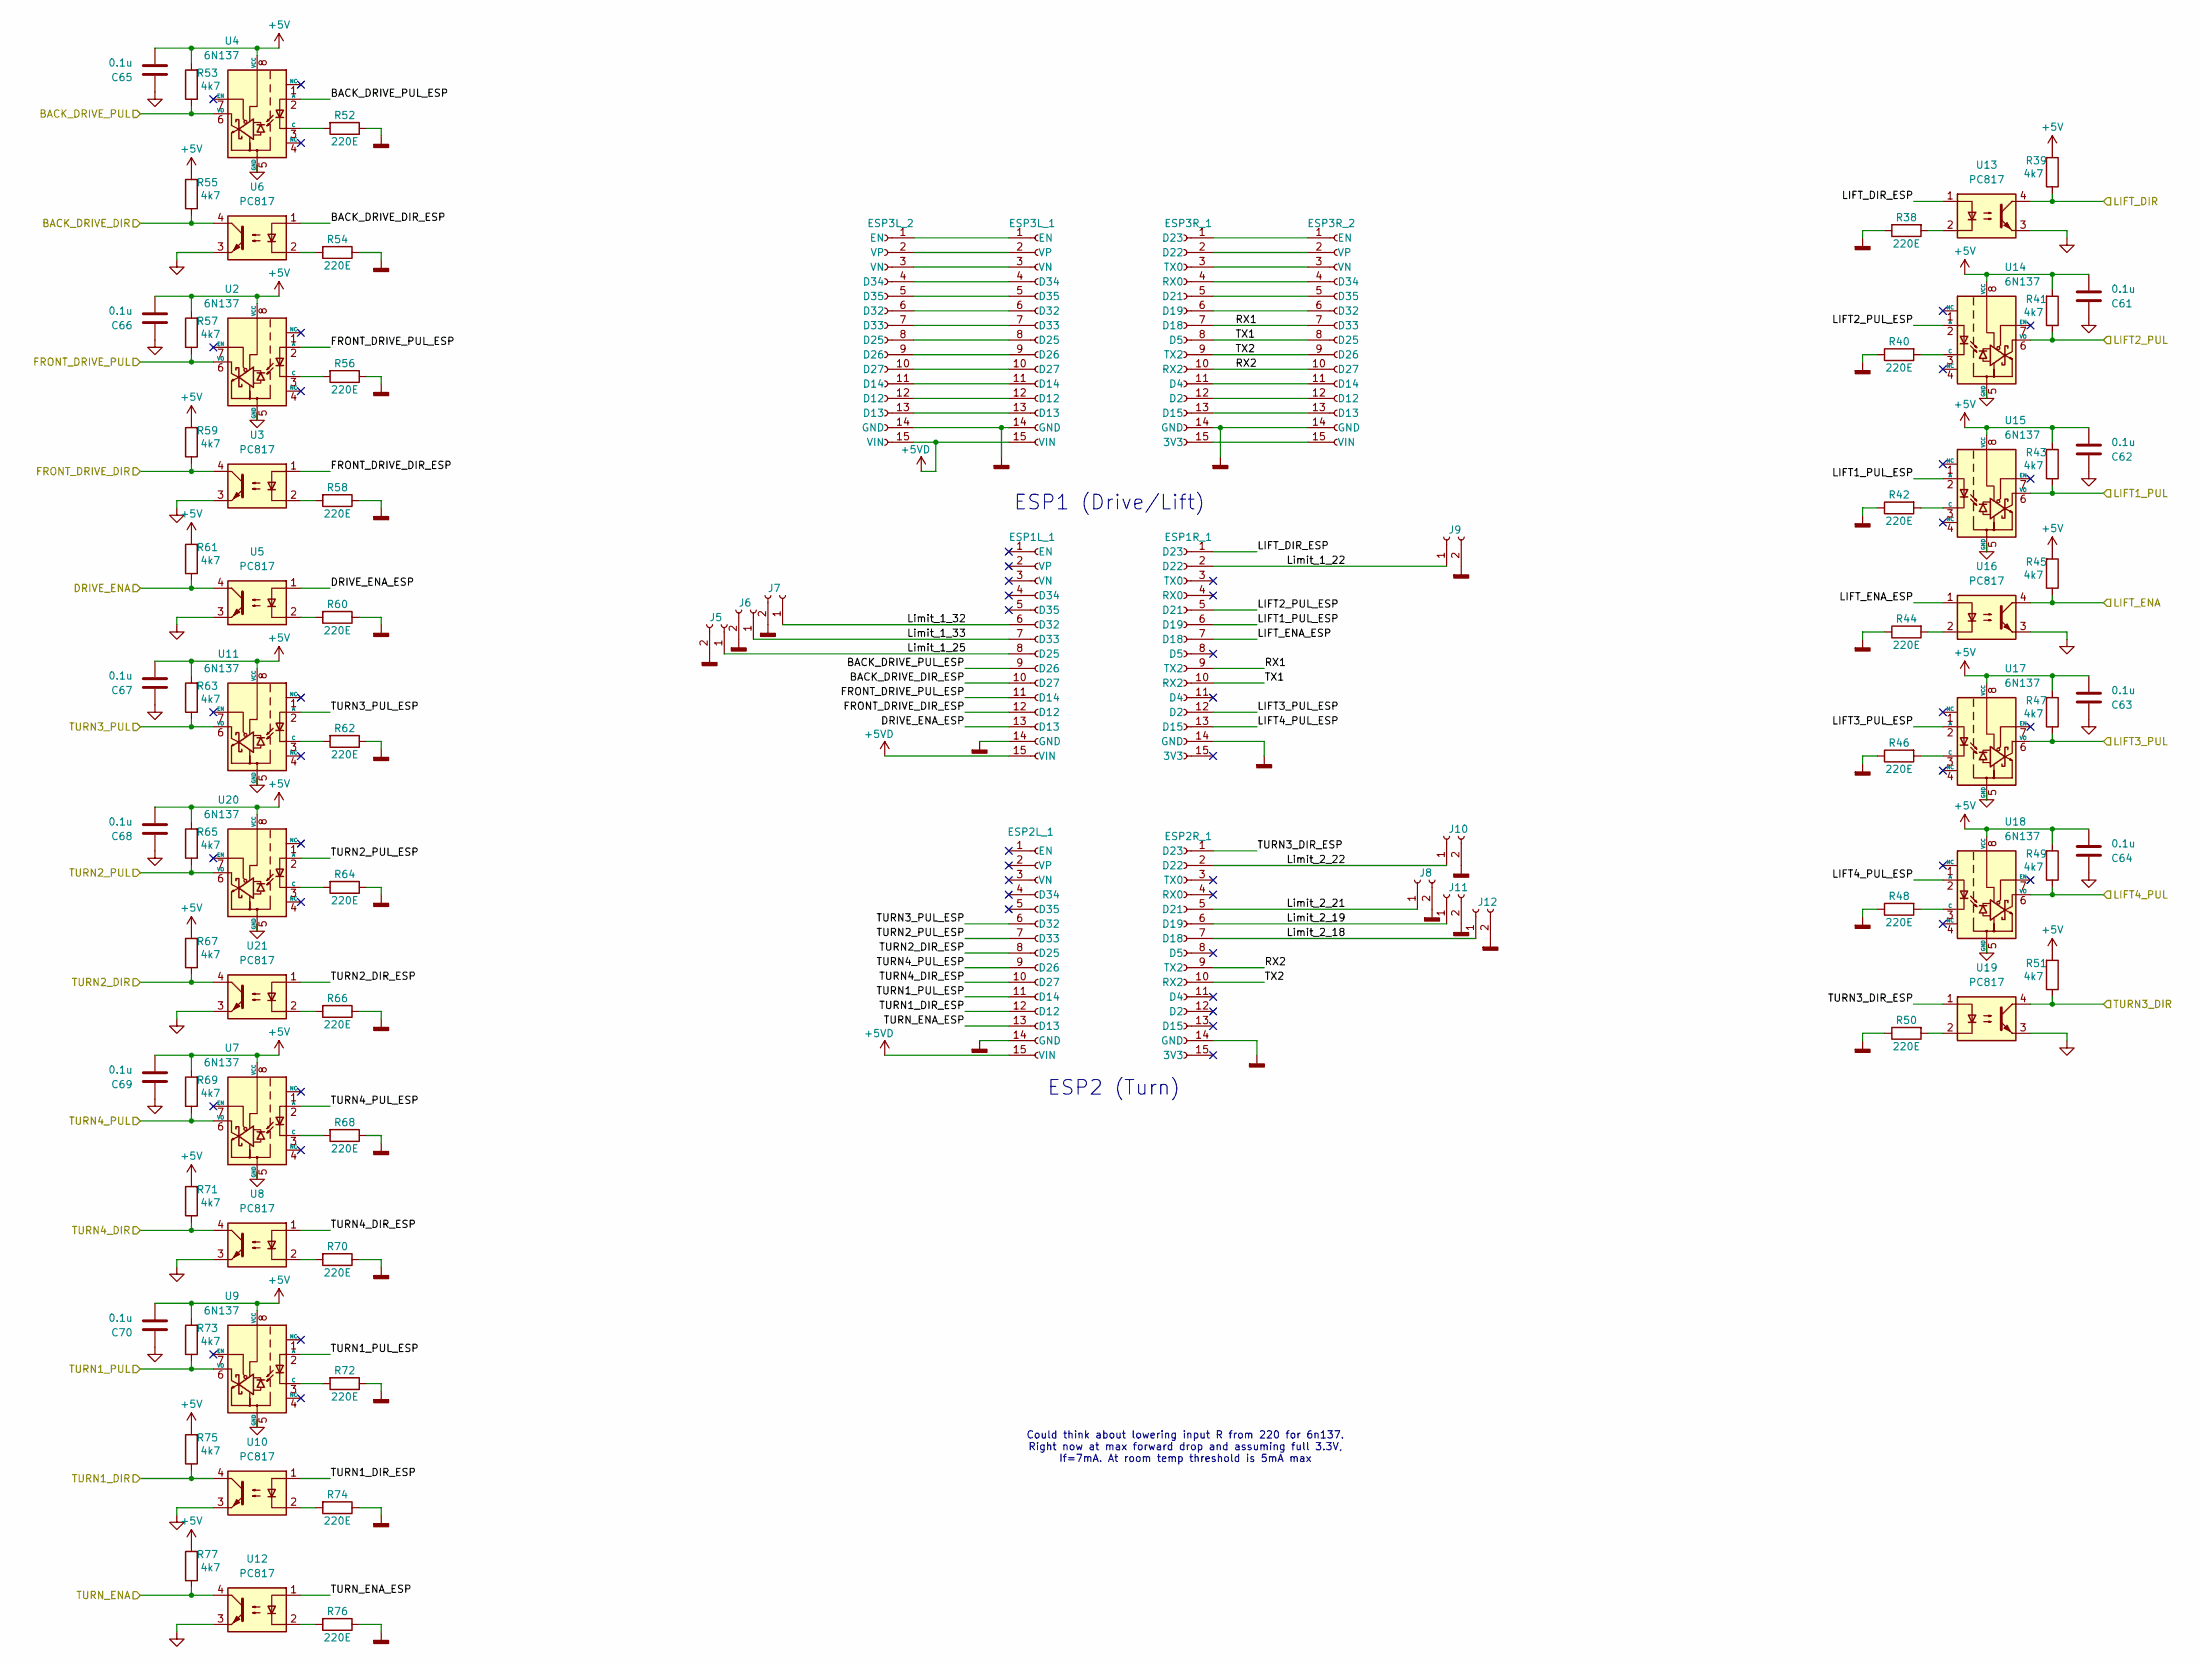
[picture p14: schematic 2ESP_Breakout.kicad_sch]

Parts:
C61, C62, C63, C64, C65, C66, C67, C68, C69, C70: 0.1u; C_0805_2012Metric
ESP1L_1, ESP1R_1, ESP2L_1, ESP2R_1, ESP3L_1, ESP3L_2, ESP3R_1, ESP3R_2: Conn_01x15_Socket; PinSocket_1x15_P2.54mm_Vertical
J5, J6, J7, J8, J9, J10, J11, J12: Conn_01x02_Socket; JST_PH_B2B-PH-K_1x02_P2.00mm_Vertical
R38, R40, R42, R44, R46, R48, R50, R52, R54, R56, R58, R60, R62, R64, R66, R68, R70, R72, R74, R76: 220E; R_0805_2012Metric
R39, R41, R43, R45, R47, R49, R51, R53, R55, R57, R59, R61, R63, R65, R67, R69, R71, R73, R75, R77: 4k7; R_0805_2012Metric
U2, U4, U7, U9, U11, U14, U15, U17, U18, U20: 6N137; DIP762W60P254L968H450Q8N
U3, U5, U6, U8, U10, U12, U13, U16, U19, U21: PC817; DIP-4_W7.62mm

Connections:
+5V: C61.1, C62.1, C63.1, C64.1, C65.1, C66.1, C67.1, C68.1, C69.1, C70.1, R39.2, R41.2, R43.2, R45.2, R47.2, R49.2, R51.2, R53.2, R55.2, R57.2, R59.2, R61.2, R63.2, R65.2, R67.2, R69.2, R71.2, R73.2, R75.2, R77.2, U2.8 (VCC), U4.8 (VCC), U7.8 (VCC), U9.8 (VCC), U11.8 (VCC), U14.8 (VCC), U15.8 (VCC), U17.8 (VCC), U18.8 (VCC), U20.8 (VCC); also elsewhere on the board
+5VD: ESP1L_1.15 (VIN), ESP2L_1.15 (VIN), ESP3L_1.15 (VIN), ESP3L_2.15 (VIN)
/BACK_DRIVE_DIR: R55.1, U6.4; also elsewhere on the board
/BACK_DRIVE_PUL: R53.1, U4.6 (VO); also elsewhere on the board
/DRIVE_ENA: R61.1, U5.4; also elsewhere on the board
/ESPs/BACK_DRIVE_DIR_ESP: ESP1L_1.10 (D27), U6.1
/ESPs/BACK_DRIVE_PUL_ESP: ESP1L_1.9 (D26), U4.2 (A)
/ESPs/DRIVE_ENA_ESP: ESP1L_1.13 (D13), U5.1
/ESPs/FRONT_DRIVE_DIR_ESP: ESP1L_1.12 (D12), U3.1
/ESPs/FRONT_DRIVE_PUL_ESP: ESP1L_1.11 (D14), U2.2 (A)
/ESPs/LIFT1_PUL_ESP: ESP1R_1.6 (D19), U15.2 (A)
/ESPs/LIFT2_PUL_ESP: ESP1R_1.5 (D21), U14.2 (A)
/ESPs/LIFT3_PUL_ESP: ESP1R_1.12 (D2), U17.2 (A)
/ESPs/LIFT4_PUL_ESP: ESP1R_1.13 (D15), U18.2 (A)
/ESPs/LIFT_DIR_ESP: ESP1R_1.1 (D23), U13.1
/ESPs/LIFT_ENA_ESP: ESP1R_1.7 (D18), U16.1
/ESPs/Limit_1_22: ESP1R_1.2 (D22), J9.1
/ESPs/Limit_1_25: ESP1L_1.8 (D25), J5.1
/ESPs/Limit_1_32: ESP1L_1.6 (D32), J7.1
/ESPs/Limit_1_33: ESP1L_1.7 (D33), J6.1
/ESPs/Limit_2_18: ESP2R_1.7 (D18), J12.1
/ESPs/Limit_2_19: ESP2R_1.6 (D19), J11.1
/ESPs/Limit_2_21: ESP2R_1.5 (D21), J8.1
/ESPs/Limit_2_22: ESP2R_1.2 (D22), J10.1
/ESPs/RX1: ESP1R_1.9 (TX2), ESP3R_1.7 (D18), ESP3R_2.7 (D33)
/ESPs/RX2: ESP2R_1.9 (TX2), ESP3R_1.10 (RX2), ESP3R_2.10 (D27)
/ESPs/TURN1_DIR_ESP: ESP2L_1.12 (D12), U10.1
/ESPs/TURN1_PUL_ESP: ESP2L_1.11 (D14), U9.2 (A)
/ESPs/TURN2_DIR_ESP: ESP2L_1.8 (D25), U21.1
/ESPs/TURN2_PUL_ESP: ESP2L_1.7 (D33), U20.2 (A)
/ESPs/TURN3_DIR_ESP: ESP2R_1.1 (D23), U19.1
/ESPs/TURN3_PUL_ESP: ESP2L_1.6 (D32), U11.2 (A)
/ESPs/TURN4_DIR_ESP: ESP2L_1.10 (D27), U8.1
/ESPs/TURN4_PUL_ESP: ESP2L_1.9 (D26), U7.2 (A)
/ESPs/TURN_ENA_ESP: ESP2L_1.13 (D13), U12.1
/ESPs/TX1: ESP1R_1.10 (RX2), ESP3R_1.8 (D5), ESP3R_2.8 (D25)
/ESPs/TX2: ESP2R_1.10 (RX2), ESP3R_1.9 (TX2), ESP3R_2.9 (D26)
/FRONT_DRIVE_DIR: R59.1, U3.4; also elsewhere on the board
/FRONT_DRIVE_PUL: R57.1, U2.6 (VO); also elsewhere on the board
/LIFT1_PUL: R43.1, U15.6 (VO); also elsewhere on the board
/LIFT2_PUL: R41.1, U14.6 (VO); also elsewhere on the board
/LIFT3_PUL: R47.1, U17.6 (VO); also elsewhere on the board
/LIFT4_PUL: R49.1, U18.6 (VO); also elsewhere on the board
/LIFT_DIR: R39.1, U13.4; also elsewhere on the board
/LIFT_ENA: R45.1, U16.4; also elsewhere on the board
/TURN1_DIR: R75.1, U10.4; also elsewhere on the board
/TURN1_PUL: R73.1, U9.6 (VO); also elsewhere on the board
/TURN2_DIR: R67.1, U21.4; also elsewhere on the board
/TURN2_PUL: R65.1, U20.6 (VO); also elsewhere on the board
/TURN3_DIR: R51.1, U19.4; also elsewhere on the board
/TURN3_PUL: R63.1, U11.6 (VO); also elsewhere on the board
/TURN4_DIR: R71.1, U8.4; also elsewhere on the board
/TURN4_PUL: R69.1, U7.6 (VO); also elsewhere on the board
/TURN_ENA: R77.1, U12.4; also elsewhere on the board
GND: C61.2, C62.2, C63.2, C64.2, C65.2, C66.2, C67.2, C68.2, C69.2, C70.2, U2.5 (GND), U3.3, U4.5 (GND), U5.3, U6.3, U7.5 (GND), U8.3, U9.5 (GND), U10.3, U11.5 (GND), U12.3, U13.3, U14.5 (GND), U15.5 (GND), U16.3, U17.5 (GND), U18.5 (GND), U19.3, U20.5 (GND), U21.3; also elsewhere on the board
GNDD: ESP1L_1.14 (GND), ESP1R_1.14 (GND), ESP2L_1.14 (GND), ESP2R_1.14 (GND), ESP3L_1.14 (GND), ESP3L_2.14 (GND), ESP3R_1.14 (GND), ESP3R_2.14 (GND), J5.2, J6.2, J7.2, J8.2, J9.2, J10.2, J11.2, J12.2, R38.1, R40.1, R42.1, R44.1, R46.1, R48.1, R50.1, R52.1, R54.1, R56.1, R58.1, R60.1, R62.1, R64.1, R66.1, R68.1, R70.1, R72.1, R74.1, R76.1
unnamed: ESP3L_1.12 (D12), ESP3L_2.12 (D12)
unnamed: ESP3L_1.13 (D13), ESP3L_2.13 (D13)
unnamed: ESP3L_1.11 (D14), ESP3L_2.11 (D14)
unnamed: ESP3L_1.8 (D25), ESP3L_2.8 (D25)
unnamed: ESP3L_1.9 (D26), ESP3L_2.9 (D26)
unnamed: ESP3L_1.10 (D27), ESP3L_2.10 (D27)
unnamed: ESP3L_1.6 (D32), ESP3L_2.6 (D32)
unnamed: ESP3L_1.7 (D33), ESP3L_2.7 (D33)
unnamed: ESP3L_1.4 (D34), ESP3L_2.4 (D34)
unnamed: ESP3L_1.5 (D35), ESP3L_2.5 (D35)
unnamed: ESP3L_1.1 (EN), ESP3L_2.1 (EN)
unnamed: ESP3L_1.3 (VN), ESP3L_2.3 (VN)
unnamed: ESP3L_1.2 (VP), ESP3L_2.2 (VP)
unnamed: ESP3R_1.15 (3V3), ESP3R_2.15 (VIN)
unnamed: ESP3R_1.12 (D2), ESP3R_2.12 (D12)
unnamed: ESP3R_1.11 (D4), ESP3R_2.11 (D14)
unnamed: ESP3R_1.13 (D15), ESP3R_2.13 (D13)
unnamed: ESP3R_1.6 (D19), ESP3R_2.6 (D32)
unnamed: ESP3R_1.5 (D21), ESP3R_2.5 (D35)
unnamed: ESP3R_1.2 (D22), ESP3R_2.2 (VP)
unnamed: ESP3R_1.1 (D23), ESP3R_2.1 (EN)
unnamed: ESP3R_1.4 (RX0), ESP3R_2.4 (D34)
unnamed: ESP3R_1.3 (TX0), ESP3R_2.3 (VN)
unnamed: R38.2, U13.2
unnamed: R44.2, U16.2
unnamed: R50.2, U19.2
unnamed: R54.2, U6.2
unnamed: R58.2, U3.2
unnamed: R60.2, U5.2
unnamed: R66.2, U21.2
unnamed: R70.2, U8.2
unnamed: R74.2, U10.2
unnamed: R76.2, U12.2
unnamed: R56.2, U2.3 (C)
unnamed: R52.2, U4.3 (C)
unnamed: R68.2, U7.3 (C)
unnamed: R72.2, U9.3 (C)
unnamed: R62.2, U11.3 (C)
unnamed: R40.2, U14.3 (C)
unnamed: R42.2, U15.3 (C)
unnamed: R46.2, U17.3 (C)
unnamed: R48.2, U18.3 (C)
unnamed: R64.2, U20.3 (C)

Notes on the sheet:
ESP2 (Turn)
Could think about lowering input R from 220 for 6n137. Right now at max forward drop and assuming full 3.3V, If=7mA. At room temp threshold is 5mA max
ESP1 (Drive/Lift)

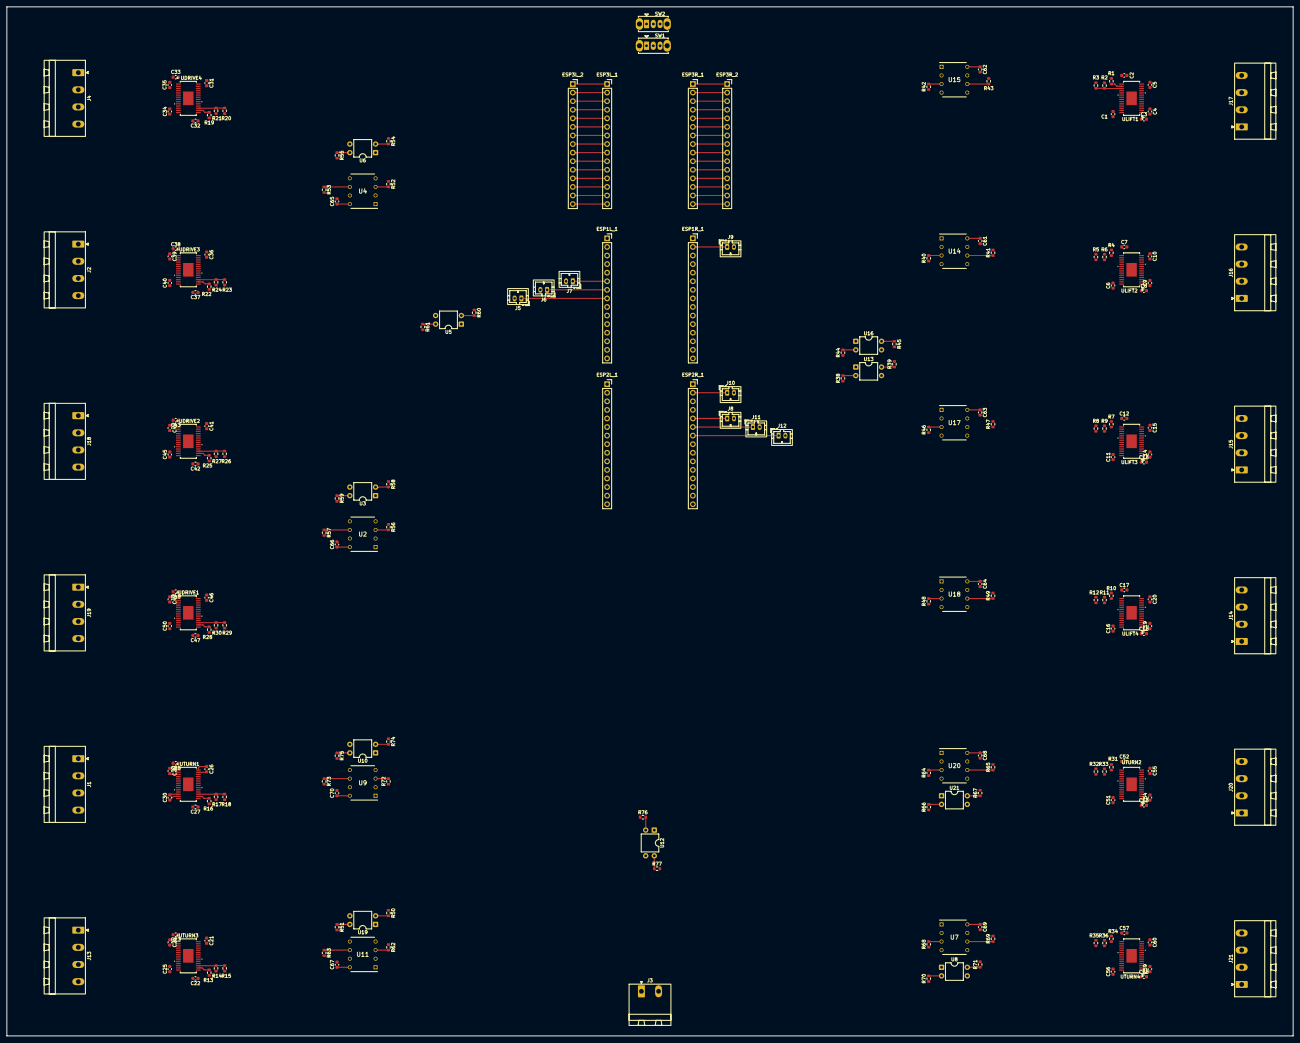
[picture p15: board 12_Driver_Board.kicad_pcb from above]

Board: 4 copper layers, 381.0 x 304.8 mm, 209 parts (0 on the bottom side), 222 nets.
