617quan/NeonCarrot/KiCad/2ESP_Breakout/2ESP_Breakout.kicad_pcb

## KiCad design KiCad/2ESP_Breakout/2ESP_Breakout.kicad_pcb (2026-03-04)

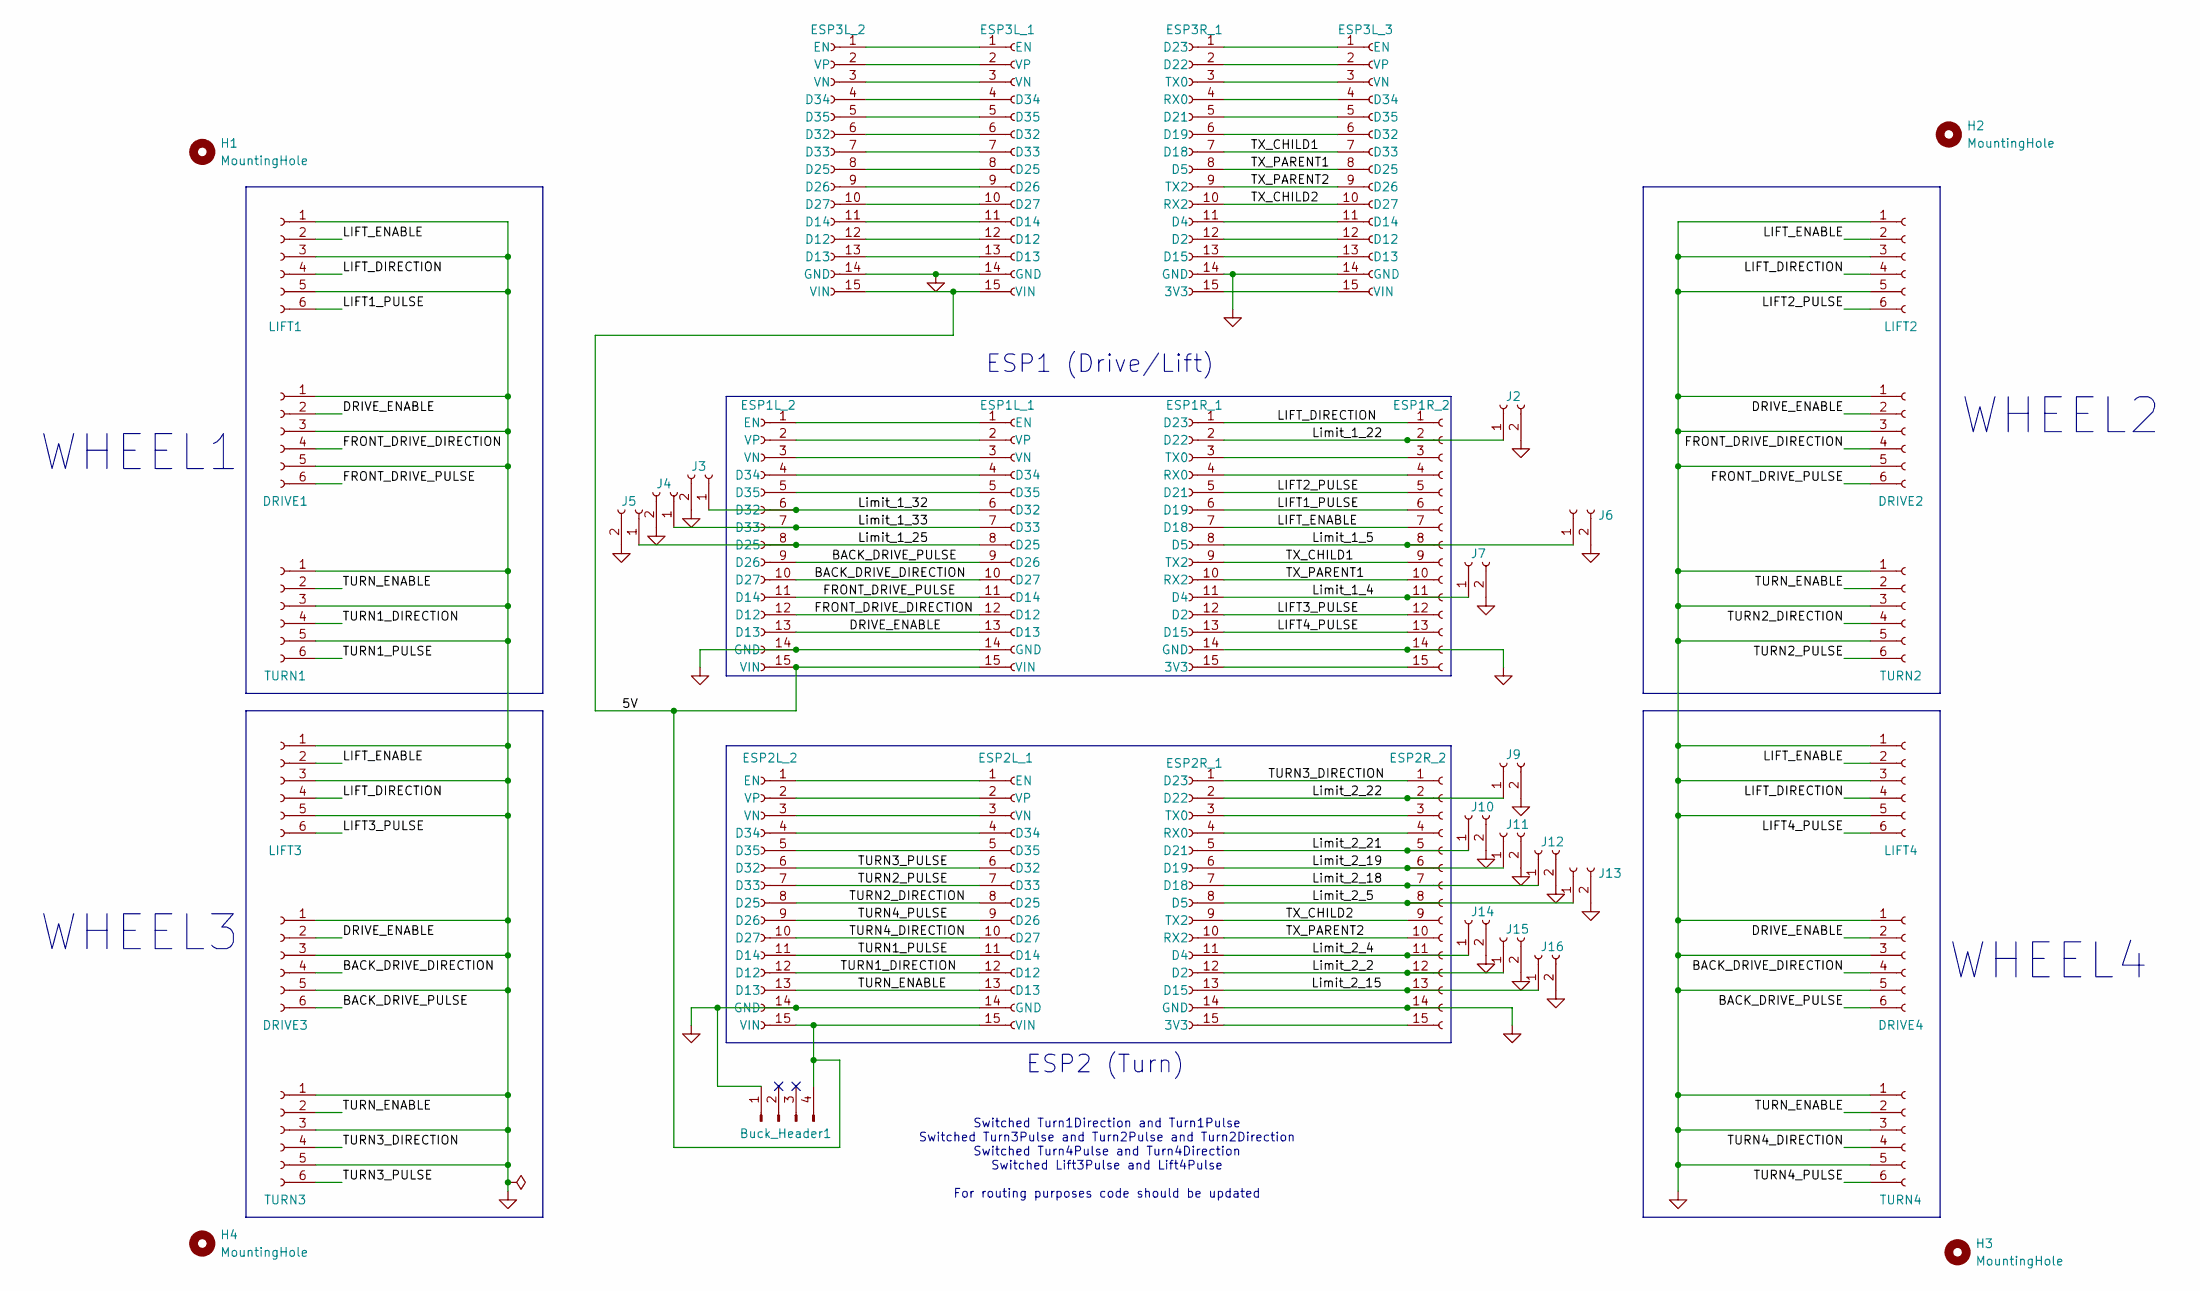
[picture p16: schematic 2ESP_Breakout.kicad_sch]

Parts:
Buck_Header1: Conn_01x04_Pin; PinHeader_1x04_P2.54mm_Vertical
DRIVE1, DRIVE2, DRIVE3, DRIVE4: Conn_01x06_Socket; JST_PH_B6B-PH-K_1x06_P2.00mm_Vertical
ESP1L_1, ESP1L_2, ESP1R_1, ESP1R_2, ESP2L_1, ESP2L_2, ESP2R_1, ESP2R_2, ESP3L_1, ESP3L_2, ESP3L_3, ESP3R_1: Conn_01x15_Socket; PinSocket_1x15_P2.54mm_Vertical
H1, H2, H3, H4: MountingHole; MountingHole_3.2mm_M3
J2, J3, J4, J5, J6, J7, J9, J10, J11, J12, J13, J14, J15, J16: Conn_01x02_Socket; JST_PH_B2B-PH-K_1x02_P2.00mm_Vertical
LIFT1, LIFT2, LIFT3, LIFT4: Conn_01x06_Socket; JST_PH_B6B-PH-K_1x06_P2.00mm_Vertical
TURN1, TURN2, TURN3, TURN4: Conn_01x06_Socket; JST_PH_B6B-PH-K_1x06_P2.00mm_Vertical

Connections:
/5V: Buck_Header1.4, ESP1L_1.15 (VIN), ESP1L_2.15 (VIN), ESP2L_1.15 (VIN), ESP2L_2.15 (VIN), ESP3L_1.15 (VIN), ESP3L_2.15 (VIN)
/BACK_DRIVE_DIRECTION: DRIVE3.4, DRIVE4.4, ESP1L_1.10 (D27), ESP1L_2.10 (D27)
/BACK_DRIVE_PULSE: DRIVE3.6, DRIVE4.6, ESP1L_1.9 (D26), ESP1L_2.9 (D26)
/DRIVE_ENABLE: DRIVE1.2, DRIVE2.2, DRIVE3.2, DRIVE4.2, ESP1L_1.13 (D13), ESP1L_2.13 (D13)
/FRONT_DRIVE_DIRECTION: DRIVE1.4, DRIVE2.4, ESP1L_1.12 (D12), ESP1L_2.12 (D12)
/FRONT_DRIVE_PULSE: DRIVE1.6, DRIVE2.6, ESP1L_1.11 (D14), ESP1L_2.11 (D14)
/LIFT1_PULSE: ESP1R_1.6 (D19), ESP1R_2.6 (D19), LIFT1.6
/LIFT2_PULSE: ESP1R_1.5 (D21), ESP1R_2.5 (D21), LIFT2.6
/LIFT3_PULSE: ESP1R_1.12 (D2), ESP1R_2.12 (D2), LIFT3.6
/LIFT4_PULSE: ESP1R_1.13 (D15), ESP1R_2.13 (D15), LIFT4.6
/LIFT_DIRECTION: ESP1R_1.1 (D23), ESP1R_2.1 (D23), LIFT1.4, LIFT2.4, LIFT3.4, LIFT4.4
/LIFT_ENABLE: ESP1R_1.7 (D18), ESP1R_2.7 (D18), LIFT1.2, LIFT2.2, LIFT3.2, LIFT4.2
/Limit_1_4: ESP1R_1.11 (D4), ESP1R_2.11 (D4), J7.1
/Limit_1_5: ESP1R_1.8 (D5), ESP1R_2.8 (D5), J6.1
/Limit_1_22: ESP1R_1.2 (D22), ESP1R_2.2 (D22), J2.1
/Limit_1_25: ESP1L_1.8 (D25), ESP1L_2.8 (D25), J5.1
/Limit_1_32: ESP1L_1.6 (D32), ESP1L_2.6 (D32), J3.1
/Limit_1_33: ESP1L_1.7 (D33), ESP1L_2.7 (D33), J4.1
/Limit_2_2: ESP2R_1.12 (D2), ESP2R_2.12 (D2), J15.1
/Limit_2_4: ESP2R_1.11 (D4), ESP2R_2.11 (D4), J14.1
/Limit_2_5: ESP2R_1.8 (D5), ESP2R_2.8 (D5), J13.1
/Limit_2_15: ESP2R_1.13 (D15), ESP2R_2.13 (D15), J16.1
/Limit_2_18: ESP2R_1.7 (D18), ESP2R_2.7 (D18), J12.1
/Limit_2_19: ESP2R_1.6 (D19), ESP2R_2.6 (D19), J11.1
/Limit_2_21: ESP2R_1.5 (D21), ESP2R_2.5 (D21), J10.1
/Limit_2_22: ESP2R_1.2 (D22), ESP2R_2.2 (D22), J9.1
/TURN1_DIRECTION: ESP2L_1.12 (D12), ESP2L_2.12 (D12), TURN1.4
/TURN1_PULSE: ESP2L_1.11 (D14), ESP2L_2.11 (D14), TURN1.6
/TURN2_DIRECTION: ESP2L_1.8 (D25), ESP2L_2.8 (D25), TURN2.4
/TURN2_PULSE: ESP2L_1.7 (D33), ESP2L_2.7 (D33), TURN2.6
/TURN3_DIRECTION: ESP2R_1.1 (D23), ESP2R_2.1 (D23), TURN3.4
/TURN3_PULSE: ESP2L_1.6 (D32), ESP2L_2.6 (D32), TURN3.6
/TURN4_DIRECTION: ESP2L_1.10 (D27), ESP2L_2.10 (D27), TURN4.4
/TURN4_PULSE: ESP2L_1.9 (D26), ESP2L_2.9 (D26), TURN4.6
/TURN_ENABLE: ESP2L_1.13 (D13), ESP2L_2.13 (D13), TURN1.2, TURN2.2, TURN3.2, TURN4.2
/TX_CHILD1: ESP1R_1.9 (TX2), ESP1R_2.9 (TX2), ESP3L_3.7 (D33), ESP3R_1.7 (D18)
/TX_CHILD2: ESP2R_1.9 (TX2), ESP2R_2.9 (TX2), ESP3L_3.10 (D27), ESP3R_1.10 (RX2)
/TX_PARENT1: ESP1R_1.10 (RX2), ESP1R_2.10 (RX2), ESP3L_3.8 (D25), ESP3R_1.8 (D5)
/TX_PARENT2: ESP2R_1.10 (RX2), ESP2R_2.10 (RX2), ESP3L_3.9 (D26), ESP3R_1.9 (TX2)
GND: Buck_Header1.1, DRIVE1.1, DRIVE1.3, DRIVE1.5, DRIVE2.1, DRIVE2.3, DRIVE2.5, DRIVE3.1, DRIVE3.3, DRIVE3.5, DRIVE4.1, DRIVE4.3, DRIVE4.5, ESP1L_1.14 (GND), ESP1L_2.14 (GND), ESP1R_1.14 (GND), ESP1R_2.14 (GND), ESP2L_1.14 (GND), ESP2L_2.14 (GND), ESP2R_1.14 (GND), ESP2R_2.14 (GND), ESP3L_1.14 (GND), ESP3L_2.14 (GND), ESP3L_3.14 (GND), ESP3R_1.14 (GND), J2.2, J3.2, J4.2, J5.2, J6.2, J7.2, J9.2, J10.2, J11.2, J12.2, J13.2, J14.2, J15.2, J16.2, LIFT1.1, LIFT1.3, LIFT1.5, LIFT2.1, LIFT2.3, LIFT2.5, LIFT3.1, LIFT3.3, LIFT3.5, LIFT4.1, LIFT4.3, LIFT4.5, TURN1.1, TURN1.3, TURN1.5, TURN2.1, TURN2.3, TURN2.5, TURN3.1, TURN3.3, TURN3.5, TURN4.1, TURN4.3, TURN4.5
unnamed: ESP1L_1.4 (D34), ESP1L_2.4 (D34)
unnamed: ESP1L_1.5 (D35), ESP1L_2.5 (D35)
unnamed: ESP1L_1.1 (EN), ESP1L_2.1 (EN)
unnamed: ESP1L_1.3 (VN), ESP1L_2.3 (VN)
unnamed: ESP1L_1.2 (VP), ESP1L_2.2 (VP)
unnamed: ESP1R_1.15 (3V3), ESP1R_2.15 (3V3)
unnamed: ESP1R_1.4 (RX0), ESP1R_2.4 (RX0)
unnamed: ESP1R_1.3 (TX0), ESP1R_2.3 (TX0)
unnamed: ESP2L_1.4 (D34), ESP2L_2.4 (D34)
unnamed: ESP2L_1.5 (D35), ESP2L_2.5 (D35)
unnamed: ESP2L_1.1 (EN), ESP2L_2.1 (EN)
unnamed: ESP2L_1.3 (VN), ESP2L_2.3 (VN)
unnamed: ESP2L_1.2 (VP), ESP2L_2.2 (VP)
unnamed: ESP2R_1.15 (3V3), ESP2R_2.15 (3V3)
unnamed: ESP2R_1.4 (RX0), ESP2R_2.4 (RX0)
unnamed: ESP2R_1.3 (TX0), ESP2R_2.3 (TX0)
unnamed: ESP3L_1.12 (D12), ESP3L_2.12 (D12)
unnamed: ESP3L_1.13 (D13), ESP3L_2.13 (D13)
unnamed: ESP3L_1.11 (D14), ESP3L_2.11 (D14)
unnamed: ESP3L_1.8 (D25), ESP3L_2.8 (D25)
unnamed: ESP3L_1.9 (D26), ESP3L_2.9 (D26)
unnamed: ESP3L_1.10 (D27), ESP3L_2.10 (D27)
unnamed: ESP3L_1.6 (D32), ESP3L_2.6 (D32)
unnamed: ESP3L_1.7 (D33), ESP3L_2.7 (D33)
unnamed: ESP3L_1.4 (D34), ESP3L_2.4 (D34)
unnamed: ESP3L_1.5 (D35), ESP3L_2.5 (D35)
unnamed: ESP3L_1.1 (EN), ESP3L_2.1 (EN)
unnamed: ESP3L_1.3 (VN), ESP3L_2.3 (VN)
unnamed: ESP3L_1.2 (VP), ESP3L_2.2 (VP)
unnamed: ESP3L_3.12 (D12), ESP3R_1.12 (D2)
unnamed: ESP3L_3.13 (D13), ESP3R_1.13 (D15)
unnamed: ESP3L_3.11 (D14), ESP3R_1.11 (D4)
unnamed: ESP3L_3.6 (D32), ESP3R_1.6 (D19)
unnamed: ESP3L_3.4 (D34), ESP3R_1.4 (RX0)
unnamed: ESP3L_3.5 (D35), ESP3R_1.5 (D21)
unnamed: ESP3L_3.1 (EN), ESP3R_1.1 (D23)
unnamed: ESP3L_3.15 (VIN), ESP3R_1.15 (3V3)
unnamed: ESP3L_3.3 (VN), ESP3R_1.3 (TX0)
unnamed: ESP3L_3.2 (VP), ESP3R_1.2 (D22)

Notes on the sheet:
ESP2 (Turn)
WHEEL3
Switched Turn1Direction and Turn1Pulse Switched Turn3Pulse and Turn2Pulse and Turn2Direction Switched Turn4Pulse and Turn4Direction Switched Lift3Pulse and Lift4Pulse For routing purposes code should be updated
WHEEL2
ESP1 (Drive/Lift)
WHEEL4
WHEEL1

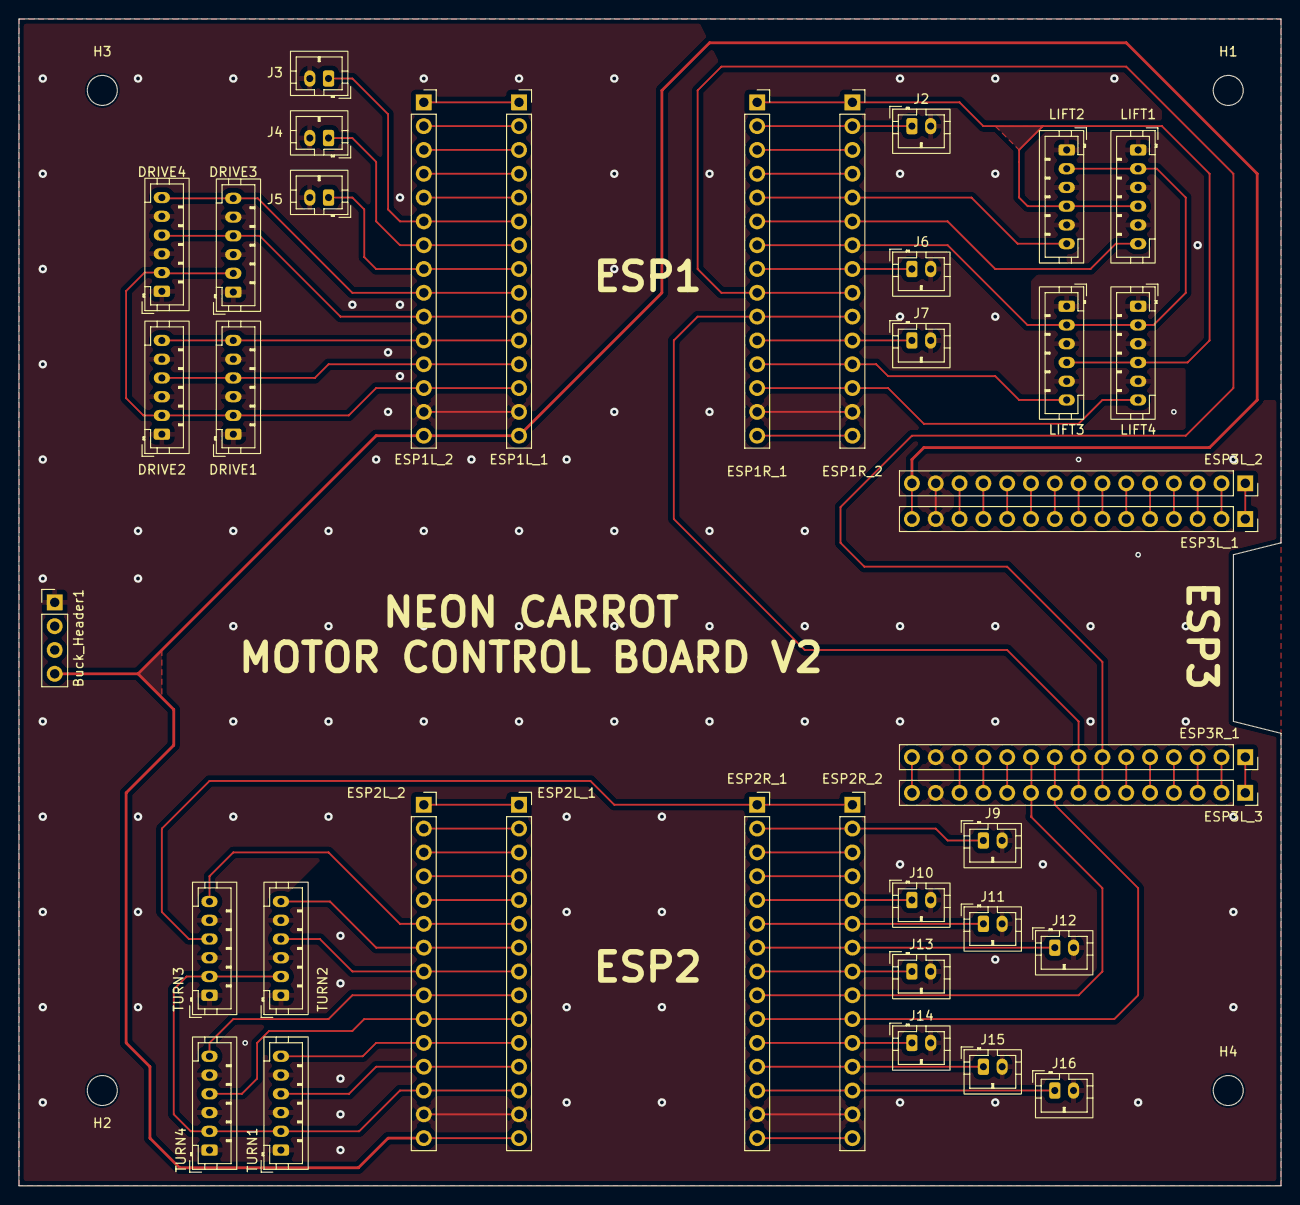
[picture p17: board 2ESP_Breakout.kicad_pcb from above]

Board: 2 copper layers, 134.6 x 124.5 mm, 43 parts (0 on the bottom side), 79 nets.
