617quan/NeonCarrot/KiCad/ESP_Breakout_V2/ESP_Breakout_V2.kicad_pcb

## KiCad design KiCad/ESP_Breakout_V2/ESP_Breakout_V2.kicad_pcb (2026-02-25)

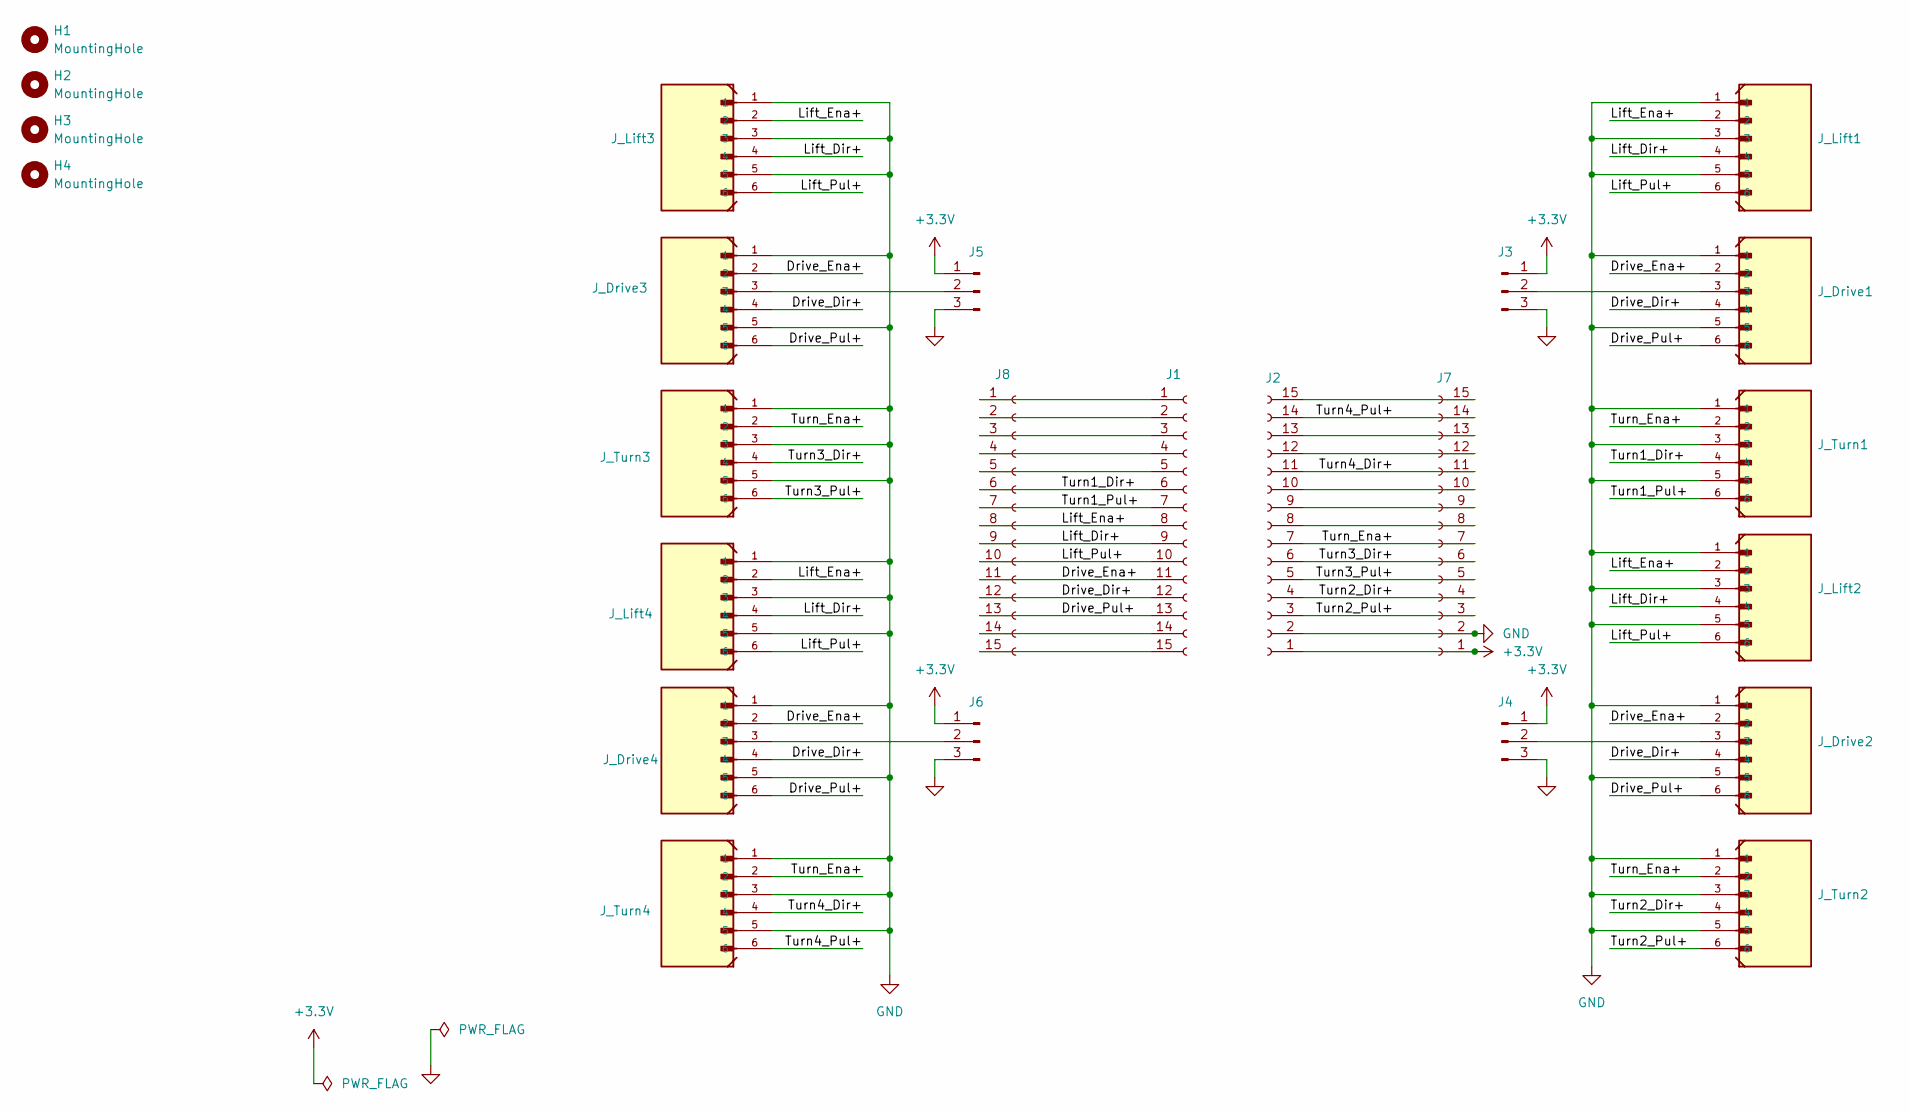
[picture p18: schematic ESP_Breakout_V2.kicad_sch]

Parts:
H1, H2, H3, H4: MountingHole; MountingHole_3.2mm_M3
J1, J2, J7, J8: Conn_01x15_Socket; PinSocket_1x15_P2.54mm_Vertical
J3, J4, J5, J6: Conn_01x03_Pin; PinHeader_1x03_P2.54mm_Vertical
J_Drive1, J_Drive2, J_Drive3, J_Drive4: B6B-PH-K-S; JST_PH_B6B-PH-K_1x06_P2.00mm_Vertical
J_Lift1, J_Lift2, J_Lift3, J_Lift4: B6B-PH-K-S; JST_PH_B6B-PH-K_1x06_P2.00mm_Vertical
J_Turn1, J_Turn2, J_Turn3, J_Turn4: B6B-PH-K-S; JST_PH_B6B-PH-K_1x06_P2.00mm_Vertical

Connections:
+3.3V: J2.1, J3.1, J4.1, J5.1, J6.1, J7.1
/Drive_Dir+: J1.12, J8.12, J_Drive1.4, J_Drive2.4, J_Drive3.4, J_Drive4.4
/Drive_Ena+: J1.11, J8.11, J_Drive1.2, J_Drive2.2, J_Drive3.2, J_Drive4.2
/Drive_Pul+: J1.13, J8.13, J_Drive1.6, J_Drive2.6, J_Drive3.6, J_Drive4.6
/Lift_Dir+: J1.9, J8.9, J_Lift1.4, J_Lift2.4, J_Lift3.4, J_Lift4.4
/Lift_Ena+: J1.8, J8.8, J_Lift1.2, J_Lift2.2, J_Lift3.2, J_Lift4.2
/Lift_Pul+: J1.10, J8.10, J_Lift1.6, J_Lift2.6, J_Lift3.6, J_Lift4.6
/Turn1_Dir+: J1.6, J8.6, J_Turn1.4
/Turn1_Pul+: J1.7, J8.7, J_Turn1.6
/Turn2_Dir+: J2.4, J7.4, J_Turn2.4
/Turn2_Pul+: J2.3, J7.3, J_Turn2.6
/Turn3_Dir+: J2.6, J7.6, J_Turn3.4
/Turn3_Pul+: J2.5, J7.5, J_Turn3.6
/Turn4_Dir+: J2.11, J7.11, J_Turn4.4
/Turn4_Pul+: J2.14, J7.14, J_Turn4.6
/Turn_Ena+: J2.7, J7.7, J_Turn1.2, J_Turn2.2, J_Turn3.2, J_Turn4.2
GND: J2.2, J3.3, J4.3, J5.3, J6.3, J7.2, J_Drive1.1, J_Drive1.5, J_Drive2.1, J_Drive2.5, J_Drive3.1, J_Drive3.5, J_Drive4.1, J_Drive4.5, J_Lift1.1, J_Lift1.3, J_Lift1.5, J_Lift2.1, J_Lift2.3, J_Lift2.5, J_Lift3.1, J_Lift3.3, J_Lift3.5, J_Lift4.1, J_Lift4.3, J_Lift4.5, J_Turn1.1, J_Turn1.3, J_Turn1.5, J_Turn2.1, J_Turn2.3, J_Turn2.5, J_Turn3.1, J_Turn3.3, J_Turn3.5, J_Turn4.1, J_Turn4.3, J_Turn4.5
unnamed: J1.1, J8.1
unnamed: J1.2, J8.2
unnamed: J1.3, J8.3
unnamed: J1.4, J8.4
unnamed: J1.5, J8.5
unnamed: J1.14, J8.14
unnamed: J1.15, J8.15
unnamed: J2.8, J7.8
unnamed: J2.9, J7.9
unnamed: J2.10, J7.10
unnamed: J2.12, J7.12
unnamed: J2.13, J7.13
unnamed: J2.15, J7.15
unnamed: J3.2, J_Drive1.3
unnamed: J4.2, J_Drive2.3
unnamed: J5.2, J_Drive3.3
unnamed: J6.2, J_Drive4.3

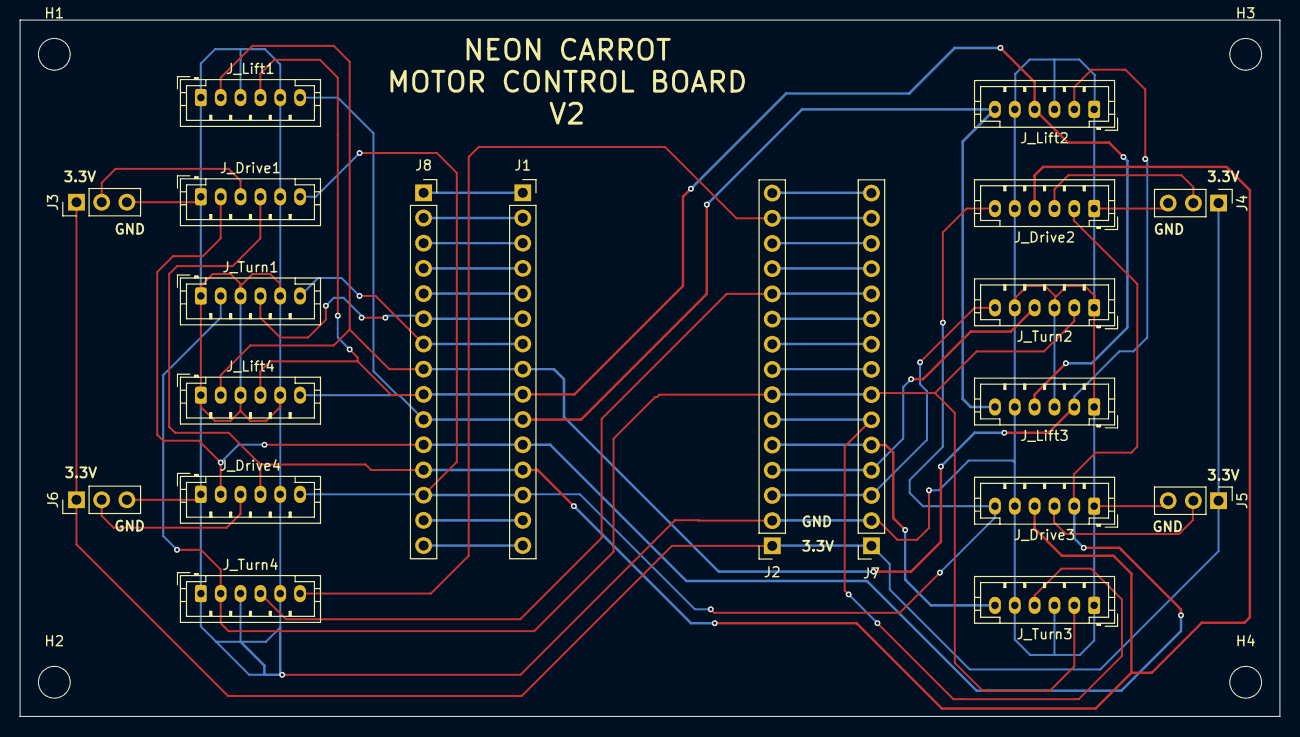
[picture p19: board ESP_Breakout_V2.kicad_pcb from above]

Board: 2 copper layers, 127.0 x 70.2 mm, 24 parts (0 on the bottom side), 34 nets.
