617quan/NeonCarrot/KiCad/Pheonix_Rail/Pheonix_Rail.kicad_pcb

## KiCad design KiCad/Pheonix_Rail/Pheonix_Rail.kicad_pcb (2026-02-05)

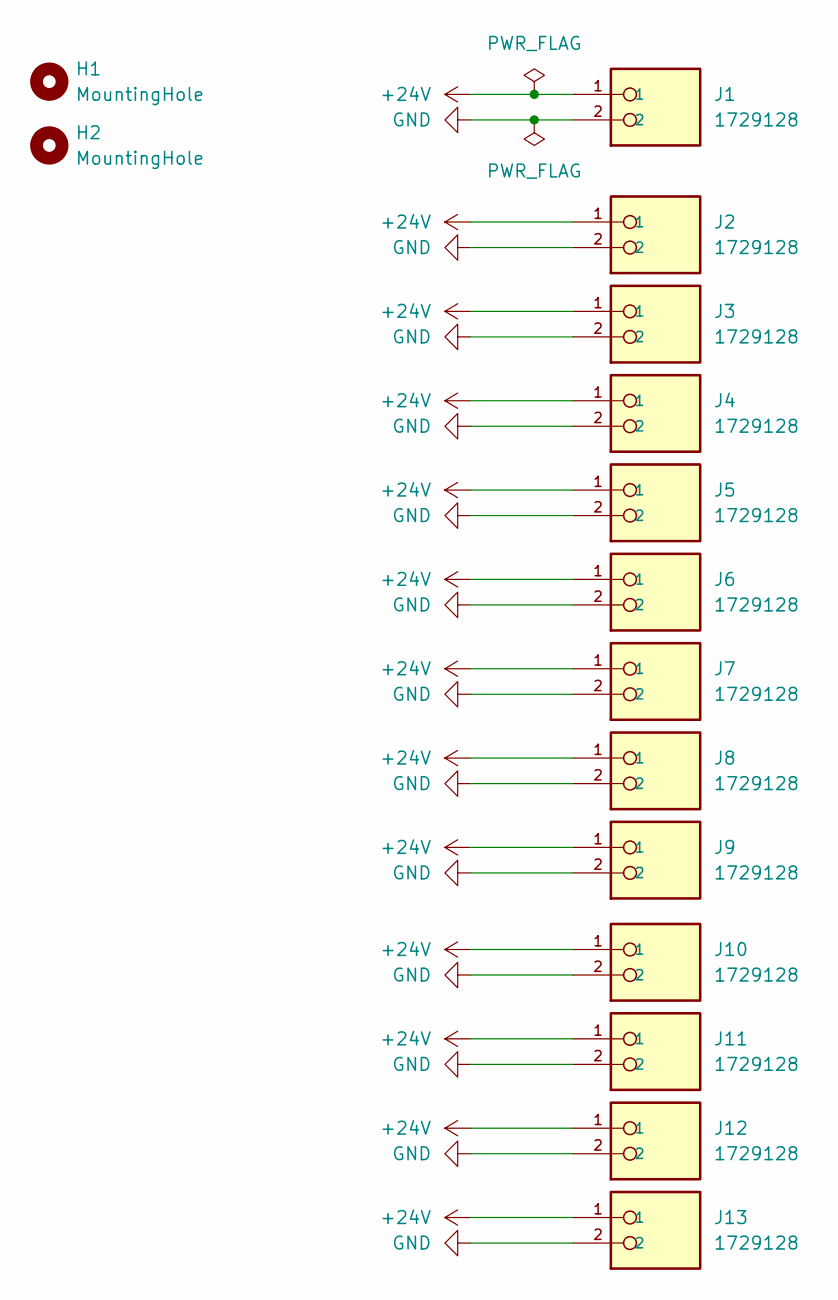
[picture p20: schematic Pheonix_Rail.kicad_sch]

Parts:
H1, H2: MountingHole; MountingHole_3.2mm_M3
J1, J2, J3, J4, J5, J6, J7, J8, J9, J10, J11, J12, J13: 1729128; PHOENIX_1729128; PARTREV 28.07.2023

Connections:
+24V: J1.1, J2.1, J3.1, J4.1, J5.1, J6.1, J7.1, J8.1, J9.1, J10.1, J11.1, J12.1, J13.1
GND: J1.2, J2.2, J3.2, J4.2, J5.2, J6.2, J7.2, J8.2, J9.2, J10.2, J11.2, J12.2, J13.2

Board: 2 copper layers, 15 parts (0 on the bottom side), 2 nets, no tracks yet.
