617quan/NeonCarrot/(commit log)

2025-10-08 10/07/25 Progress
    added wheel.cpp
    added wheel.h (motor struct)
    worked on main.cpp
    pinout_defines.h to define pinout
2025-10-08 connected pins to struct
    Put motor struct in wheel class
    connected pins to drive motor
2025-10-08 Using the ledc functions to make a square wave
2025-10-08 Square wave finally oscillates, just really slow and clunky
    [main.cpp]
2025-10-09 motor.cpp and motor.h created, and a shit ton of documentation on StepperEngine
2025-10-09 motor constructor constructed
2025-10-15 Bye bye motor class hello wheel class
2025-10-24 Added struct to wheel.h for pins, wheel initialization is a little different, and movement functions are updated with new functionality
2025-10-28 It isn't working, but I'm trying to fix it
    [main.cpp]
2025-10-30 started spi
2025-10-30 Skeleton for SPI in main.cpp
    haven't tested but need to make another main with child code, this code is for the parent esp
2025-10-30 SPI rework
    Changed master slave lingo to computer peripheral MOSI -> COPI. Finished the parent main.cpp didn't figure out child main.cpp also didn't build
    [child_main.cpp, parent_main.cpp]
2025-10-31 i didn't achieve anything
    [FastAccelDocumentation.cpp]
2025-10-31 Added SPI child implementation
    Haven't debugged yet but parent esp is using arduino <SPI.h>, child is using ESP-IDF functions.
2025-11-03 mid debug for SPI
    sorry not finished. Also having UART open would solve all of the issues in 1/10 the time
    [child_main.cpp, parent_main.cpp]
2025-11-05 child fucntion not working
    only because we are lazy. rec_buf has the correct message from parent we just don't know how to translate it to a something to return.
    [child_main.cpp, parent_main.cpp]
2025-11-11 State Machine
    Bare bones state machine. Need to edit child and parent SPI mains to transmit ints and not char arrays to interface with state machine (will make sending messages easier SLAY and faster SLAY)
2025-11-12 parent and child spi transmitting uint8_t messages
    lez plug this in and see if it works
2025-11-13 About to start writing new motor class
2025-11-16 Frame class compiles. Just copied from wheel
2025-11-17 Documentation for frame struct done
2025-11-17 Made frame_board_main.cpp to flash frame code. It's a spi child
2025-11-21 adding KiCad project to repo
    [Driver_layout.kicad_pcb, Driver_layout.kicad_sch]
2025-11-22 Interfaced web server class w/ frame class
2026-01-23 Adding kicad stuff
    [B6B-PH-K-S.step, ESP_Breakout.kicad_pcb, ESP_Breakout.kicad_sch, Stepper_Driver_Board_TI_DRV8434.kicad_pcb, Stepper_Driver_Board_TI_DRV8434.kicad_sch]
2026-01-24 Worked on schematic
    [ESP_Breakout.kicad_sch]
2026-01-25 import esp32 devkit
    [ESP_Breakout.kicad_sch]
2026-01-25 saved changes
    [ESP_Breakout.kicad_pcb]
2026-01-27 footprint assignments
    [ESP_Breakout.kicad_sch]
2026-01-28 starting pcb layout
    [ESP_Breakout.kicad_pcb, ESP_Breakout.kicad_sch]
2026-01-30 wiring progress
    [ESP_Breakout.kicad_pcb]
2026-02-02 start of pheonix
    [ESP_Breakout.kicad_pcb, ESP_Breakout.kicad_sch, Pheonix_Rail.kicad_pcb, Pheonix_Rail.kicad_sch]
2026-02-03 Adding my changes
    [BOM.csv, C0603C103K5RACTU.step, CCS_CCSTD_0603_L1.75W0.95T0.87B0.35.step, CCS_CCSTD_0603_L1.75W0.95T0.95B0.35.step, CRCW060310K0FKEA.step, CRCW0603220RFKEA.step, CRCW06034K70FKEA.step, GRM188R71H224KAC4D.step]
2026-02-03 worked on layout
    [C0603C103K5RACTU.step, CCS_CCSTD_0603_L1.75W0.95T0.87B0.35.step, CCS_CCSTD_0603_L1.75W0.95T0.95B0.35.step, CRCW060310K0FKEA.step, CRCW0603220RFKEA.step, CRCW06034K70FKEA.step, GRM188R71H224KAC4D.step, Stepper_Driver_Board_TI_DRV8434.kicad_pcb]
2026-02-03 Some minor cleanup of frame.h
2026-02-03 changed mounting holes
    [ESP_Breakout.kicad_pcb, ESP_Breakout.kicad_sch, Pheonix_Rail.kicad_pcb, Pheonix_Rail.kicad_sch]
2026-02-05 layout for phoenix board
    [Pheonix_Rail.kicad_pcb]
2026-02-05 Updated some library stuff
    [GRM188R71H224KAC4D.step, UMK107AB7105KA-T.step]
2026-02-06 Made Gerbers
    [ESP_Breakout-B_Cu.gbr, ESP_Breakout-B_Mask.gbr, ESP_Breakout-B_Paste.gbr, ESP_Breakout-B_Silkscreen.gbr, ESP_Breakout-Edge_Cuts.gbr, ESP_Breakout-F_Cu.gbr, ESP_Breakout-F_Mask.gbr, ESP_Breakout-F_Paste.gbr]
2026-02-06 fixed lift motor max speed
    [frame.h, frame_board_main.cpp]
2026-02-12 Finished Rough Layout!
    [Stepper_Driver_Board_TI_DRV8434.kicad_pcb, Stepper_Driver_Board_TI_DRV8434.kicad_sch]
2026-02-12 Fixed some via stuff
    [Stepper_Driver_Board_TI_DRV8434.kicad_pcb]
2026-02-17 esp32 custom board
    erm not done yet
    [ESP32_D0WDQ6_bare_metal.kicad_pcb, ESP32_D0WDQ6_bare_metal.kicad_sch]
2026-02-17 Bare metal update
    Added VSPI connector and other stuff
    [ESP32_D0WDQ6_bare_metal.kicad_sch]
2026-02-18 about to test arduino mega
2026-02-25 driver board updating
    [Stepper_Driver_Board_TI_DRV8434.kicad_pcb, Stepper_Driver_Board_TI_DRV8434.kicad_sch]
2026-02-26 Kicad stuff
    [2ESP_Breakout.kicad_pcb, 2ESP_Breakout.kicad_sch, B6B-PH-K-S.step, ESP32-DEVKIT-V1.step, Stepper_Driver_Board_TI_DRV8434.kicad_pcb]
2026-02-27 Did some initial routing on breakout2
    [2ESP_Breakout.kicad_pcb, 2ESP_Breakout.kicad_sch, Stepper_Driver_Board_TI_DRV8434.kicad_pcb]
2026-02-28 Cleaned up routing
    [2ESP_Breakout.kicad_pcb, 2ESP_Breakout.kicad_sch]
2026-02-28 Added Ground Plane and stiching vias
    [Stepper_Driver_Board_TI_DRV8434.kicad_pcb, Stepper_Driver_Board_TI_DRV8434.kicad_sch]
2026-03-02 Needs some more work on 2esp
    [2ESP_Breakout.kicad_pcb, 2ESP_Breakout.kicad_sch, Stepper_Driver_Board_TI_DRV8434.kicad_pcb, Stepper_Driver_Board_TI_DRV8434.kicad_sch]
2026-03-04 Final KiCad stuff for 2ESP and Driver Board
    [2ESP_Breakout.kicad_pcb, 2ESP_Breakout.kicad_sch, Stepper_Driver_Board_TI_DRV8434.kicad_pcb]
2026-03-05 datasheets for BOM
    [2ESP_Breakout.csv, 2ESP_Breakout.kicad_sch]
2026-03-08 Started the big board
    [12_Driver_Board.kicad_pcb, 12_Driver_Board.kicad_sch, 2ESP_Breakout.kicad_sch, BOM.csv, GRM188R71H224KAC4D.step, PWP0028M.stp, UMK107AB7105KA-T.step]
2026-05-02 Adding Cad files
    [12_Driver_Board.kicad_pcb, 12_Driver_Board.kicad_sch, 2ESP_Breakout.kicad_sch, ESP32-DEVKIT-V1.step, Stepper_3Chain(4-13).STL, Stepper_3Chain_BothHoles.STL]
2026-05-02 more CAD files added
    [PCB_Case_Bottom.stl, PCB_Lid_a.stl]
